devtank-ltd/kicad_hiltop_seni_board/Sensi_Board_BOM_wcost.ods

Sheet: PCB
Customer | Product Group |  | Item No. | Description | Details | Mf. Part No. | Supplier 1 | Part no. 1 | Cost 1 | Supplier 2 | Part no. 2 | Cost 2
JMA | 300 |  | 001 | Production RET Tester – Main Board | 1.6mm FR4 4 Layer
 |  |  | 002 | Production RET Tester – Connector Board | 1.6mm FR4 4 Layer
 | 301 |  | 001 | Autosense – Connector Board | 1.6mm FR4 4 Layer
 | 301 |  | 002 | Autosense – Power Load Board | 1.6mm FR4 4 Layer
 | 301 |  | 003 | Autosense – Test fixture PCB | 1.6mm FR4 4 Layer
Sheffield Uni | 302 |  | 001 | Roving Sensor Board | 1.6mm FR4 4 Layer
RedEmbedded | 303 | - | 001 | OVO Motherboard | 1.6mm FR4 4 Layer
HILTOP | 304 | - | 001 | Motherboard | 1.6mm FR4 4 Layer
 | 304 |  | 002 | Backplane | 1.6mm FR4 4 Layer
 | 304 |  | 003 | FPGA Modolu Board | 1.6mm FR4 4 Layer
 | 304 |  | 004 | USB Front Panel Board | 1.6mm FR4 4 Layer
 |  |  | 005 | Rear Connector Panel | 1.6mm FR4 4 Layer
 |  |  | 006 | LoTa IO Board (Plug-in) | 1.6mm FR4 4 Layer
Indra | 305 | - | 001 | Smart Charger Breakout Board | 1.6mm FR4 4 Layer
Teledyne | 306 | - | 001 | LED Interface Board A – JIG | 1.6mm FR4 4 Layer
 | 306 |  | 002 | LED Interface Board B – HILTOP | 1.6mm FR4 4 Layer
 | 307 | -
 | 308 | -
 | 309 | -
 | 310 | - | 001
 | 311 | -
 | 312 | -
 | 313 | -
 | 314 | -
 | 315 | -
 | 316 | -
 | 317 | -
 | 318 | -
 | 319 | -
 | 320 | -
 | 321 | -
 | 322 | -
 | 323 | -
 | 324 | -
 | 325 | -
 | 326 | -
 | 327 | -
 | 328 | -
 | 329 | -
 | 330 | -
 | 331 | -
 | 332 | -
 | 333
 | 334

Sheet: Sensi_Board
Title | Sensi Board
Revision | Draft
Date | 2019-10-01
Generated | Wed 23 Oct 2019 13:36:07 BST
Company
Comment 1
Comment 2
Comment 3
Comment 4
Total Parts | 434
Total Unique Parts | 78
Ref | Qty | Value | Footprint | Devtank | Dielectric | Tolerance | Voltage | Description | Manufacturer | Manufacturer Part Number | Supplier | Supplier Part number | Cost (unit) | Cost (total)
C1 C3 C7 C8 C20 C21 C22 C25 C32 C35 C39 C43 C48 C51 C62 C70 C81 C82 | 18 | 100nF | Capacitor_SMD:C_0603_1608Metric | 105-002 |  |  |  | 100nF 50V X7R | Kemet | C0603C104M5RACTU | Farnell | 2581046 | 0.018 | 0.324
C2 C4 C5 C6 C9 C12 C14 C15 C16 C17 C18 C19 C23 C24 C26 C27 C28 C29 C30 C56 C60 C61 C66 C67 C73 C74 C79 C80 | 28 | 100nF | Capacitor_SMD:C_0402_1005Metric | 105-019 |  |  |  | 100nF 50V X7R | Murata Electronics | GRM155R71H104ME14D | Digikey | 490-10701-1-ND | 0.0151 | 0.4228
C10 C11 | 2 | 10uF | Capacitor_SMD:C_0805_2012Metric | 105-001 |  |  |  | 10uF 16V X5R 10% MLCC | AVX | 0805YD106KAT2A | Farnell | 1658880 | 0.425 | 0.85
C13 | 1 | 100uF | Capacitor_SMD:CP_Elec_6.3x7.7 | 108-003 |  |  |  | 100uF 50V 0.34R FT Series | Panasonic | EEEFTH101XAP | Farnell | 1868426 | 0.592 | 0.592
C31 C33 C34 C36 C38 C41 C42 C44 | 8 | 1uF | Capacitor_SMD:C_0603_1608Metric | 105-027 |  |  |  | 1uF 50V X5R | Samsun Electro-Mechanics | CL10A105KB8NNNC | Farnell | 3013383 | 0.106 | 0.848
C37 C40 C45 C46 C53 C68 C72 C83 C92 C94 C95 C96 C97 C98 C99 C101 | 16 | 0.1uF | Capacitor_SMD:C_0402_1005Metric | 105-019 |  |  |  | 100nF 50V X7R | Murata Electronics | GRM155R71H104ME14D | Digikey | 490-10701-1-ND | 0.0151 | 0.2416
C47 C49 C50 C54 C59 C65 C69 C71 | 8 | 1nF | Capacitor_SMD:C_0603_1608Metric | 105-026 |  |  |  | 1000pF 50V X7R | Multicomp PRO | MCU0603R102KCT | Farnell | 9406174 | 0.023 | 0.184
C52 | 1 | DNF | Capacitor_SMD:C_0603_1608Metric
C55 C102 C104 | 3 | 4.7uF | Capacitor_SMD:C_0402_1005Metric | 105-028 | X5R |  | 6.3V | 4.7uF 6.3V X5R | muRata | GRM155R60J475ME47D | Farnell | 2426952RL | 0.106 | 0.318
C57 C58 C63 C64 | 4 | DNF | Capacitor_SMD:C_0805_2012Metric
C75 C76 | 2 | 18pF | Capacitor_SMD:C_0603_1608Metric | 106-003 |  |  |  | 18pF COG/NPO | AVX | 06035A180JAT2A | Farnell | 1612182 | 0.0681 | 0.1362
C77 C78 | 2 | 4.3pF | Capacitor_SMD:C_0603_1608Metric | 106-014 |  |  |  | 4.3pF COG/NPO | Kemet | C0603C439D1HACTU | Mouser | 80-C0603C439D1HACTU | 0.019 | 0.038
C88 C89 | 2 | 33pF | Capacitor_SMD:C_0603_1608Metric | 106-015 |  |  |  | 33pF COG/NPO | Multicomp Pro | MC0603N330J500CT | Farnell | 1759059 | 0.0311 | 0.0622
C90 | 1 | 0.1uF | Capacitor_SMD:C_0603_1608Metric | 105-002 |  |  |  | 100nF 50V X7R | Kemet | C0603C104M5RACTU | Farnell | 2581046 | 0.018 | 0.018
C91 | 1 | 1.0uF | Capacitor_SMD:C_0402_1005Metric | 105-025 | X5R |  | 16V | 1uf 16V X5R | Taiyo Yuden | EMK105BJ105KV-F | Farnell | 2113064 | 0.0415 | 0.0415
C100 C103 C105 | 3 | 4.7uF | Capacitor_SMD:C_0402_1005Metric | 105-028 | X5R |  | 6.3V | 4.7uF 6.3V X5R | muRata | GRM155R60J475ME47D | Farnell | 2426952RL | 0.106 | 0.318
C106 | 1 | DNF | Capacitor_SMD:C_0402_1005Metric
D1 | 1 | B240A-13 | Diode_SMD:D_SMA | 133-008 |  |  |  | B240A-13-F - Schottky Rectifier, 40 V, 2 A, Single, DO-214AC, 2 Pins, 500 mV | Diodes Inc. | B240A-13-F | Farnell | 1843669 | 0.329 | 0.329
D2 D3 D5 D13 | 4 | GRN | LED_SMD:LED_0603_1608Metric | 110-002 |  |  |  | Green LED | Rohm Semiconductor | SML-D12P8WT86C | Farnell | 2687486 | 0.214 | 0.856
D4 | 1 | BAT54T1G | Diode_SMD:D_SOD-123 | 133-007 |  |  |  | BAT54T1G Small Signal Schottky Diode, Single, 30V, 200mA | ON Semi | BAT54T1G | Farnell | 1651157 | 0.159 | 0.159
D14 D16 D18 D20 D22 D24 | 6 | BAV99 | Package_TO_SOT_SMD:SOT-23 | 134-001 |  |  |  | BAV99 - Small Signal Diode, Dual Series, 75 V, 300 mA, 1.25 V, 4 ns, 4.5 | Diodes Inc | BAV99 | Farnell | 1902422 | 0.104 | 0.624
D32 | 1 | MBR230LSFT1G | Diode_SMD:D_SOD-123 | 133-006 |  |  |  | Schottky Rectifier, 30 V, 2 A, Single, SOD-123FL | ON Semi | MBR230LSFT1G | Farnell | 2317422 | 0.226 | 0.226
F1 | 1 | Polyfuse | Resistor_SMD:R_1206_3216Metric | 190-003 |  |  |  | PPTC Resettable Fuse, SMD, POLYFUSE 1206L | Littlefuse | 1206L075THYR | Farnell | 1822204 | 0.269 | 0.269
J1 J2 J4 J5 J7 J8 J9 | 7 | Conn_02x06_Top_Bottom | Devtank_PCB_Lib:Molex2x06 | 711-004 |  |  |  | Molex Milli-Grid 87831, 12 Way, 2 Row, Straight PCB Header | Molex | 87831-1219 | Mouser | 538-87831-1219 | 0.811 | 5.677
J3 | 1 | Conn_03x32_DIN41612 | Devtank_PCB_Lib:Socket_DIN41612-CaseC1-full-Male-96Pin-3rows_correct | 717-002 |  |  |  | 406AF-96-MSR-AAE4 (Cards) | Valcon | 406AF-96-MSR-AAE4 | Toby | 406AF-96-MSR-AAE4 | 1.54 | 1.54
J6 | 1 | Conn_02x10_Counter_Clockwise | Devtank_PCB_Lib:Molex_Milligrid_2x10 | 711-005 |  |  |  | 0878312019 Molex Milligrid 20 way 2 row | Molex | 878312019 | Digikey | WM23626-ND | 0.91 | 0.91
J10 | 1 | Conn_02x05_Counter_Clockwise | Connector_PinHeader_2.54mm:PinHeader_2x05_P2.54mm_Vertical | 710-020 |  |  |  | 2x5 THD - Valcon 2.54mm Pitch Dual Row Pin Header | Valcon | THD-05-R | Toby | THD-05-R | 0.09 | 0.09
JP1 | 1 | Jumper_NC_Dual | Connector_PinHeader_2.54mm:PinHeader_1x03_P2.54mm_Vertical | 710-014 |  |  |  | 3 Way Header (shroudless) THS - Valcon 2.54mm Single Row Pin Header | Valcon | THS-03-R | Toby | THS-03-R | 0.04 | 0.04
JP2 JP3 JP4 JP5 | 4 | Jumper_NC_Small | Connector_PinHeader_1.27mm:PinHeader_1x02_P1.27mm_Vertical | 714-005 |  |  |  | M50-3530242 - Board-To-Board Connector, 1.27 mm, 2 Contacts, Header | Harwin Inc | M50-3530242 | Farnell | 3226045 | 0.052 | 0.208
K1 | 1 | HRS1KH-S | Devtank_PCB_Lib:Relay_SPDT_HRS1KH-S | 141-002 |  |  |  | Signal Relay 5VDC SPDT 24V 3A HRS1K Series | Multicomp | HRS1KH-S DC5V | Farnell | 9480293 | 1.37 | 1.37
L1 | 1 | 500mA/0.10DCR | Inductor_SMD:L_0805_2012Metric | 113-004 |  |  |  | BMB2A0030AN8 30ohm 500ma 0.1ohm 25% | TE Connectivity | BMB2A0030AN8 | Farnell | 2483667 | 0.0874 | 0.0874
L3 L4 L6 L7 L11 | 5 | 2A/0.05DCR | Inductor_SMD:L_0805_2012Metric | 113-002 |  |  |  | Ferrite 220 ohm, 2 A, WE-CBF Series, 0.05 ohm, ± 25% | Wurth Elektronik | 742792022 | Farnell | 1635733 | 0.177 | 0.885
Q2 Q7 Q8 Q10 Q11 | 5 | ZXMN6A07F | Package_TO_SOT_SMD:SOT-23 | 170-002 |  |  |  | ZXMN6A07F N Channel 1A, 60V, 0.4Ohm | Diodes Inc | ZXMN6A07FTA | Farnell | 9525769 | 0.416 | 2.08
R1 R2 R5 R6 R50 | 5 | 470R | Resistor_SMD:R_0603_1608Metric | 101-001 |  |  |  | 470R 1% 75V | Vishay | CRCW0603470RFKEA | Farnell | 1469815 | 0.0149 | 0.0745
R3 R4 R7 R12 R14 R18 R21 R24 R26 R37 R38 R52 R99 R102 R105 R111 R120 R132 R133 R147 R148 R159 R160 R161 R162 | 25 | 10K | Resistor_SMD:R_0603_1608Metric | 101-010 |  |  |  | 10K 1% 75V | Vishay | CRCW060310K0FKEA | Farnell | 1469748 | 0.0153 | 0.3825
R8 R9 | 2 | DNF | Resistor_SMD:R_1206_3216Metric
R10 R11 | 2 | 0R | Resistor_SMD:R_1206_3216Metric | 101-007 |  |  |  | 0R 1206 200V | Vishay | CRCW12060000Z0EA | Farnell | 1469963 | 0.0377 | 0.0754
R13 R49 R53 R55 R63 R64 R65 R67 | 8 | 10R | Resistor_SMD:R_0603_1608Metric | 101-058 |  |  |  | 10R 1% 50V | Multicomp Pro | MCWR06X10R0FTL | Farnell | 2447233 | 0.0035 | 0.028
R15 R16 | 2 | 4K7 | Resistor_SMD:R_0603_1608Metric | 101-009 |  |  |  | 4K7 1% 75V | Vishay | CRCW06034K70FKEA | Farnell | 1469807 | 0.0149 | 0.0298
R17 R31 R33 R36 R74 R77 R96 R108 R110 R112 R137 R138 R143 R144 | 14 | DNF | Resistor_SMD:R_0603_1608Metric
R19 R22 R25 R27 | 4 | 16K | Resistor_SMD:R_0603_1608Metric | 101-052 |  |  |  | 16K 1% 75V | Vishay | CRCW060316K0FKEA | Farnell | 2138433 | 0.0192 | 0.0768
R20 | 1 | 47K | Resistor_SMD:R_0603_1608Metric | 101-016 |  |  |  | 47K 1% 50V | Bourns Inc | CR0603-FX-4702ELF | Farnell | 2333548 | 0.0193 | 0.0193
R23 R28 R29 R35 | 4 | 100R | Resistor_SMD:R_0603_1608Metric | 101-018 |  |  |  | 100R 1% 50V 100mW CR Series | Bourns Inc | CR0603-FX-1000ELF | Farnell | 2008332 | 0.0196 | 0.0784
R30 R32 R34 R60 R61 R66 R76 R79 R80 R83 R84 R114 R116 R121 R149 | 15 | 0R | Resistor_SMD:R_0603_1608Metric | 101-005 |  |  |  | 0R 0603 75V | Vishay | CRCW06030000Z0EA | Farnell | 1469739 | 0.0153 | 0.2295
R39 R40 R90 R93 R94 R95 R106 R107 R139 R140 | 10 | 100K | Resistor_SMD:R_0603_1608Metric | 101-015 |  |  |  | 100K 1% 50V | Multicomp Pro | MCWR06X1003FTL | Farnell | 2447226 | 0.0034 | 0.034
R41 R45 R85 R86 R97 R98 | 6 | DNF | Resistor_SMD:R_0805_2012Metric
R42 R43 R88 R89 R100 R101 R119 R122 R125 R126 R127 R128 R129 R130 R151 R152 R153 R154 | 18 | 1K | Resistor_SMD:R_0603_1608Metric | 101-012 |  |  |  | 1K 1% 75V | Vishay | CRCW06031K00FKEA | Farnell | 1469740 | 0.0151 | 0.2718
R44 R46 R91 R92 R103 R104 | 6 | 0R | Resistor_SMD:R_0805_2012Metric | 101-006 |  |  |  | 0R 0805 | Vishay | CRCW08050000Z0EA | Farnell | 1469846 | 0.0224 | 0.1344
R47 R51 | 2 | 4.7K | Resistor_SMD:R_0603_1608Metric | 101-009 |  |  |  | 4K7 1% 50V | Vishay | CRCW06034K70FKEA | Farnell | 1469807 | 0.0149 | 0.0298
R48 | 1 | 2K2 | Resistor_SMD:R_0603_1608Metric | 101-011 |  |  |  | 2.2K 1% | Vishay | CRCW06032K20FKEA | Farnell | 1469765 | 0.0153 | 0.0153
R54 R57 R69 R70 | 4 | 30R | Resistor_SMD:R_0603_1608Metric | 103-004 |  | 0.1% |  | 30R 0.1% | TE Connectivity | CPF0603B30RE1 | Farnell | 2331137 | 0.139 | 0.556
R56 R58 R71 R72 | 4 | 12.4K | Resistor_SMD:R_0603_1608Metric | 103-003 |  | 0.1% |  | 12.4K 0.1% | Multicomp Pro | MCWF06R1242BTL | Farnell | 2336957 | 0.0935 | 0.374
R59 R62 R73 R113 R115 R123 R155 R156 | 8 | DNF | Resistor_SMD:R_0603_1608Metric |  |  | 0.1%
R68 R131 R157 R158 | 4 | 1.58K | Resistor_SMD:R_0603_1608Metric | 103-005 |  | 0.1% |  | 1.58K 0.1% | Panasonic | ERA3AEB1581V | Farnell | 1809753 | 0.241 | 0.964
R75 | 1 | 10K | Resistor_SMD:R_0603_1608Metric | 101-010 |  |  |  | 10K 1% | Vishay | CRCW060310K0FKEA | Farnell | 1469748 | 0.0153 | 0.0153
R78 | 1 | 24K | Resistor_SMD:R_0603_1608Metric | 101-055 |  |  |  | 24k 1% | Multicomp Pro | MCWR06X2402FTL | Farnell | 2447308 | 0.0034 | 0.0034
R81 R82 R124 R141 R142 | 5 | 330R | Resistor_SMD:R_0603_1608Metric | 101-024 |  |  |  | 330R 1% | Vishay | CRCW0603330RFKEA | Farnell | 1469803 | 0.0149 | 0.0745
R87 | 1 | 1M | Resistor_SMD:R_0603_1608Metric | 101-056 |  |  |  | 1M 1% | Multicomp Pro | MCWR06X1004FTL | Farnell | 2447285 | 0.0035 | 0.0035
R109 | 1 | 12.0K | Resistor_SMD:R_0603_1608Metric | 101-044 |  | 1% |  | 12K 1% 50V 100mW | Bourns Inc | CR0603-FX-1202ELF | Farnell | 2333583 | 0.0193 | 0.0193
R117 R118 R134 R135 R136 R145 R146 R150 | 8 | 10M | Resistor_SMD:R_0603_1608Metric | 101-057 |  |  |  | 10M 1% | Multicomp Pro | MCWR06W1005FTL | Farnell | 2447232 | 0.0041 | 0.0328
SW1 | 1 | SW_Push | Button_Switch_SMD:SW_SPST_B3U-1000P | 780-001 |  |  |  | Switch SMT Micro SPST-NO | Omron | B3U-1000P | Mouser | 653-B3U-1000P | 0.794 | 0.794
SW2 SW3 SW4 SW5 | 4 | SW_DIP_x04 | Button_Switch_SMD:SW_DIP_SPSTx04_Slide_Copal_CHS-04B_W7.62mm_P1.27mm | 193-003 |  |  |  | 4 Way Surface Mount DIP Switch SPST, Flush Slide Actuator | Apem | DHA-04T-Q | RS Online | 877-2390 | 1.16 | 4.64
TP1 TP2 TP3 TP4 TP5 TP6 TP7 TP8 TP9 TP10 TP11 TP12 TP13 TP14 TP15 TP16 TP17 TP18 TP19 TP25 TP26 TP27 TP28 TP29 TP30 TP31 TP32 TP33 TP34 TP35 TP36 TP37 TP38 TP39 TP40 TP45 TP46 TP49 TP51 TP52 TP53 TP54 TP55 TP56 TP57 TP58 TP59 TP60 TP61 TP62 TP63 TP64 TP65 TP66 TP67 TP68 TP69 TP70 TP71 TP72 TP73 TP74 TP75 TP76 TP77 TP78 TP79 TP80 TP81 TP82 TP83 TP84 TP85 TP86 TP87 TP88 TP89 TP90 TP91 TP92 TP93 TP94 TP95 TP96 TP97 TP98 TP99 TP100 TP101 TP102 TP103 TP104 TP105 TP106 TP107 TP126 | 96 | Test_Point | TestPoint:TestPoint_THTPad_D1.0mm_Drill0.5mm
U1 | 1 | INA250A4 | Package_SO:TSSOP-16_4.4x5mm_P0.65mm | 119-002 |  |  |  | INA250 Current Shunt Monitor 2V/A (A4) | Texas Instruments | INA250A4PWR | Digikey | 296-43804-1-ND | 2.183 | 2.183
U2 | 1 | LD1117S33TR_SOT223 | Package_TO_SOT_SMD:SOT-223-3_TabPin2 | 150-004 |  |  |  | LM1117IMP-3.3 Fixed LDO Regulator 3.3V | Texas Instruments | LM1117IMP-3.3/NOPB | Digikey | LM1117IMP-3.3/NOPBCT-ND | 0.797 | 0.797
U3 | 1 | AT25DN512CSSHF-B | Package_SO:SOIC-8_3.9x4.9mm_P1.27mm | 129-002 |  |  |  | 512K, 2.3V, 104MHz Serial Flash | Adesto | AT25DN512C-SSHF-B (https://www.mouser.co.uk/ProductDetail/Adesto-Technologies/AT25DN512C-SSHF-B) | Mouser | 988-AT25DN512CSSHF-B | 0.233 | 0.233
U4 U5 | 2 | AD8646 | Package_SO:SOIC-8_3.9x4.9mm_P1.27mm | 120-006 |  |  |  | AD8646ARZ Analog Devices, Op Amp, RRIO, 24MHz, 3 V, 5 V, 8-Pin SOIC | Analog Devices | AD8646ARZ | RS Online | 709-7278 | 1.882 | 3.764
U6 | 1 | LM75B | Package_SO:SOIC-8_3.9x4.9mm_P1.27mm | 155-005 |  |  |  | LM75BD Temperature Sensor -55degC to +125degC | NXP | LM75BD | Farnell | 1854077 | 0.494 | 0.494
U7 | 1 | DNF | Package_SO:SOIC-8_3.9x4.9mm_P1.27mm
U8 U9 U10 U11 | 4 | MAX31865 | Package_DFN_QFN:TQFN-20-1EP_5x5mm_P0.65mm_EP3.1x3.1mm | 155-006 |  |  |  | MAX31865ATP+ RTD chip | Maxim Integrated | MAX31865ATP+ | RS Online | 866-6087 | 2.56 | 10.24
U12 U16 U19 U20 U21 U23 U24 U25 | 8 | MAX4194 | Package_SO:SOIC-8_3.9x4.9mm_P1.27mm | 120-005 |  |  |  | MAX4194ESA+ Maxim, Instrumentation Amplifier, 0.69mV Offset 250kHz, R-RO, 2.7 → 7.5 V, 8-Pin SOIC | Maxim | MAX4194ESA+ | Mouser | 700-MAX4194ESA | 2.5 | 20
U13 | 1 | CP2102N-A01-GQFN24 | Package_DFN_QFN:QFN-24-1EP_4x4mm_P0.5mm_EP2.6x2.6mm_ThermalVias | 118-007 |  |  |  | CP2102N USB to UART adapter IC | Silicon Labs | CP2102N-A01-GQFN24 | Digikey | 336-3693-ND | 1.09 | 1.09
U14 U15 U17 U18 | 4 | BTS4140N | Package_TO_SOT_SMD:SOT-223 | 146-001 |  |  |  | BTS4140NHUMA1 Smart Power Switch, SIPMOS Technology, High Side, 1 Output, 0.7A, | Infineon | BTS4140NHUMA1 | Farnell | 2215503 | 1.07 | 4.28
U22 | 1 | STM32F072RBTx | Package_QFP:LQFP-64_10x10mm_P0.5mm | 126-001 |  |  |  | STM32F072RBT6, 32bit ARM Cortex M0 Microcontroller, 48MHz, 64 kB, 128 kB Flash | ST Microelectronics | STM32F072RBT6 | RS Online | 907-4757 | 3.155 | 3.155
U27 | 1 | USB2502 | Package_DFN_QFN:QFN-36-1EP_6x6mm_P0.5mm_EP3.7x3.7mm | 118-012 |  |  |  | USB2502 | Microchip | USB2502-AEZG | Mouser | 886-USB2502-AEZG | £1.96 | £1.96
Y1 | 1 | 50ppm 24.000MHZ | Crystal:Crystal_SMD_TXC_7A-2Pin_5x3.2mm | 181-011 |  |  |  | TXC 24MHz crystal 30ppm | TXC | 7A-24.000MAHE-T | Mouser | 717-7A-24.000MAHE-T | 0.496 | 0.496
Y2 | 1 | 8MHZ | Crystal:Crystal_SMD_Abracon_ABM3C-4Pin_5.0x3.2mm | 181-009 |  |  |  | ABM3B-8.000MHZ-B2-T - Crystal, 8 MHz, SMD, 5mm x 3.2mm, 50 ppm, 18 pF, 20 ppm | Abracon | ABM3B-8.000MHZ-B2-T | Farnell | 2467818 | 0.501 | 0.501
Y3 | 1 | ABS25-32.768KHZ-6-T | Crystal:Crystal_SMD_7050-4Pin_7.0x5.0mm | 181-008 |  |  |  | Crystal, 32.768 kHz, SMD, 8mm x 3.8mm | Abracon | ABS25-32.768KHZ-6-T | Farnell | 2101354 | 0.518 | 0.518
 |  |  |  |  |  |  |  |  |  |  |  |  |  | 78.412
BOM made with KICAD_BOM_WIZARD (https://github.com/HashDefineElectronics/KiCad_BOM_Wizard.git)
Generated Wed 23 Oct 2019 13:36:07 BST
