devtank-ltd/kicad_hiltop_seni_board/kicad_hiltop_sensi_board/Sensi_Board.pdf

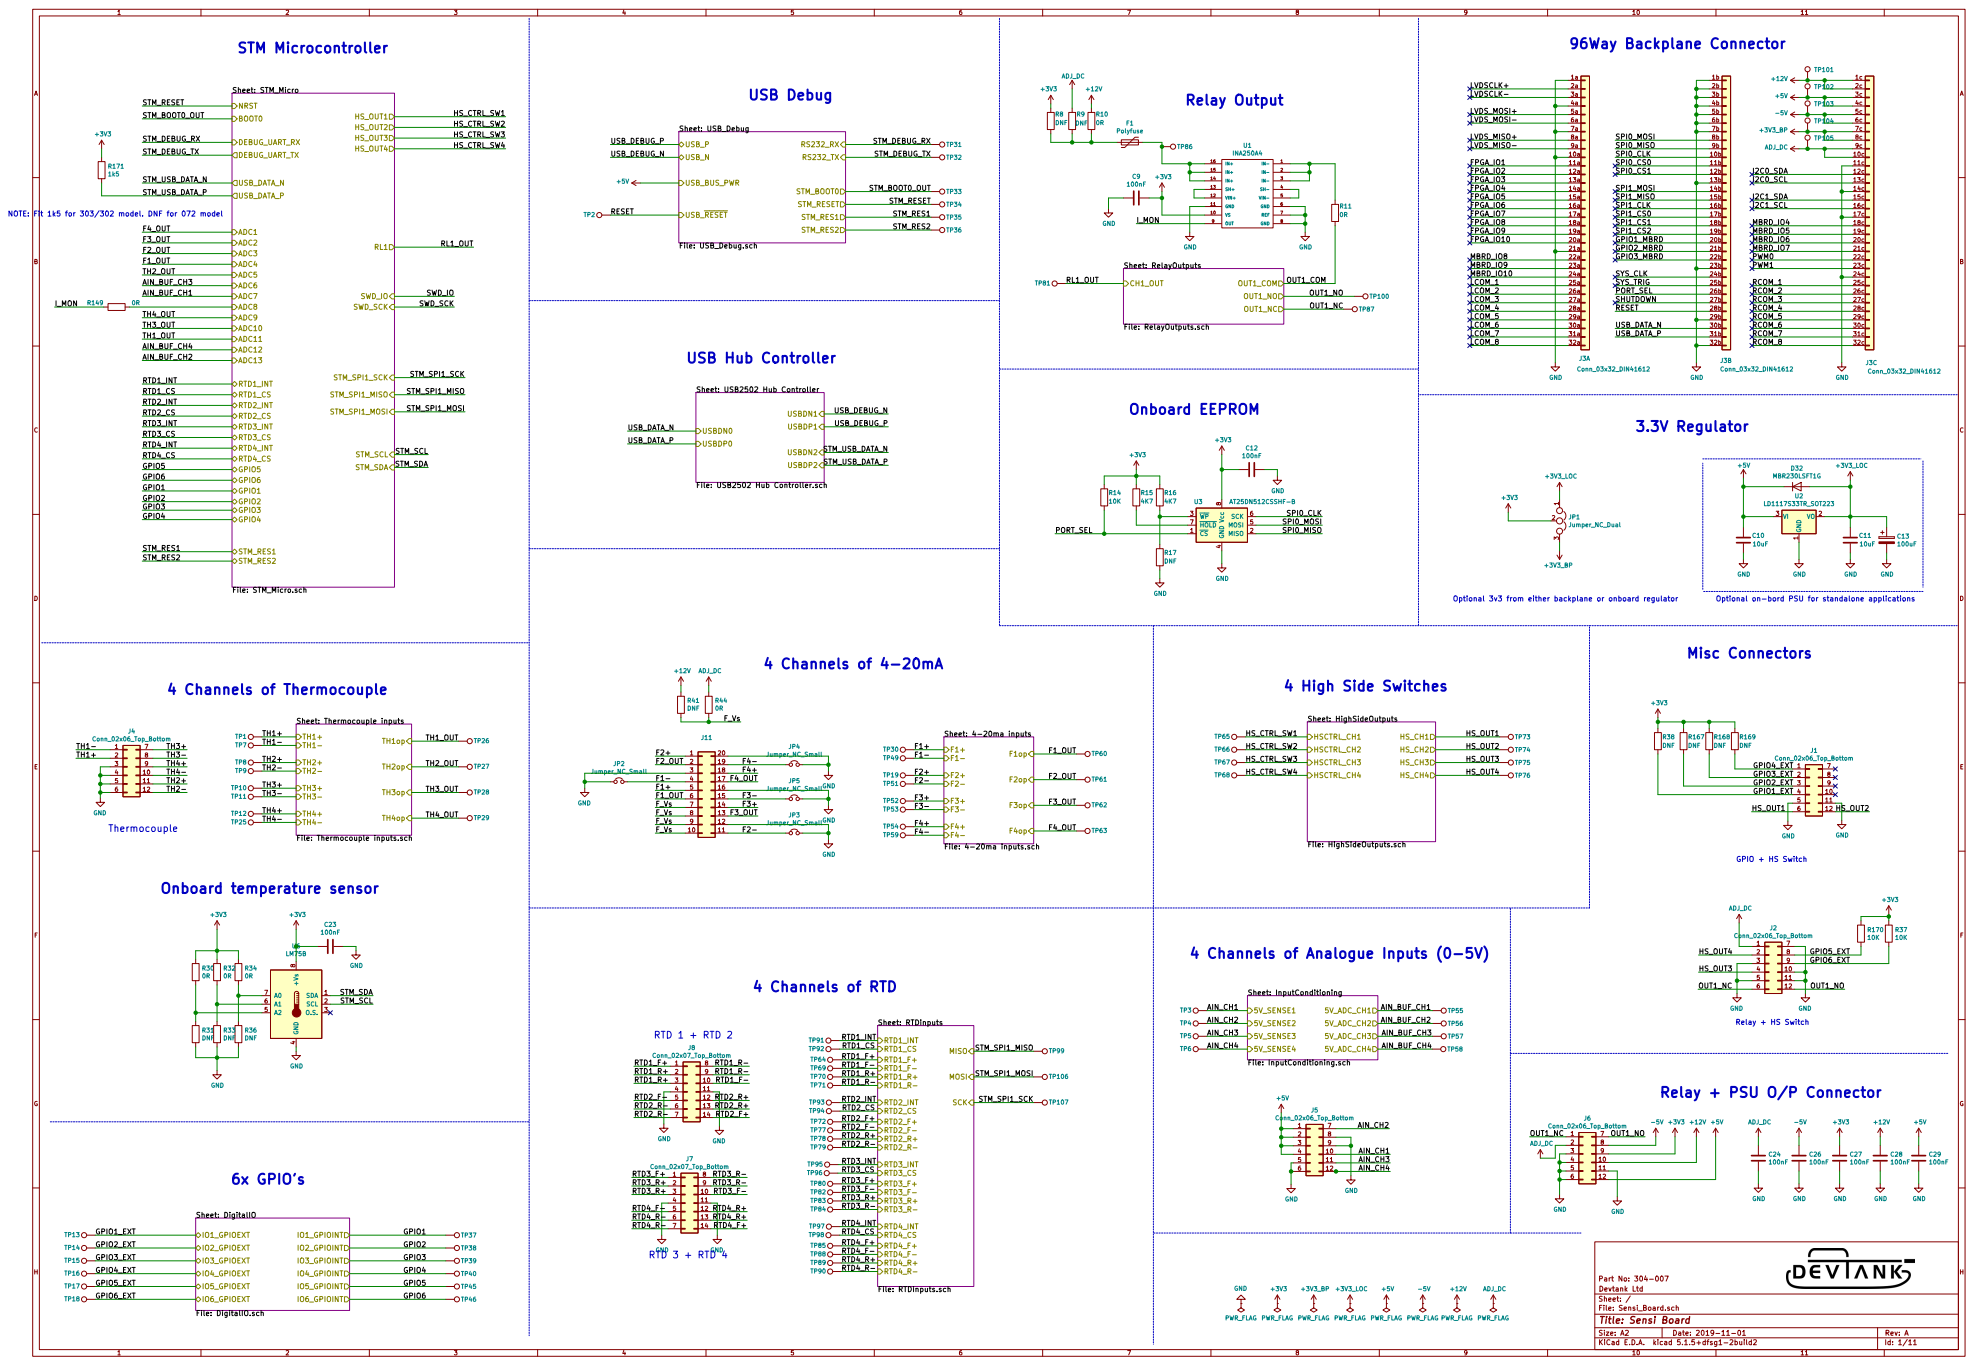
[picture p1: page 1]

NOTE: Fit 1k5 for 303/302 model. DNF for 072 model

File: USB2502 Hub Controller.sch

Optional 3v3 from either backplane or onboard regulator

Optional on-bord PSU for standalone applications

4 Channels of Analogue Inputs (0-5V)

File: Sensi_Board.sch Sheet: / Devtank Ltd Part No: 304-007

Id: 1/11 Title: Sensi Board

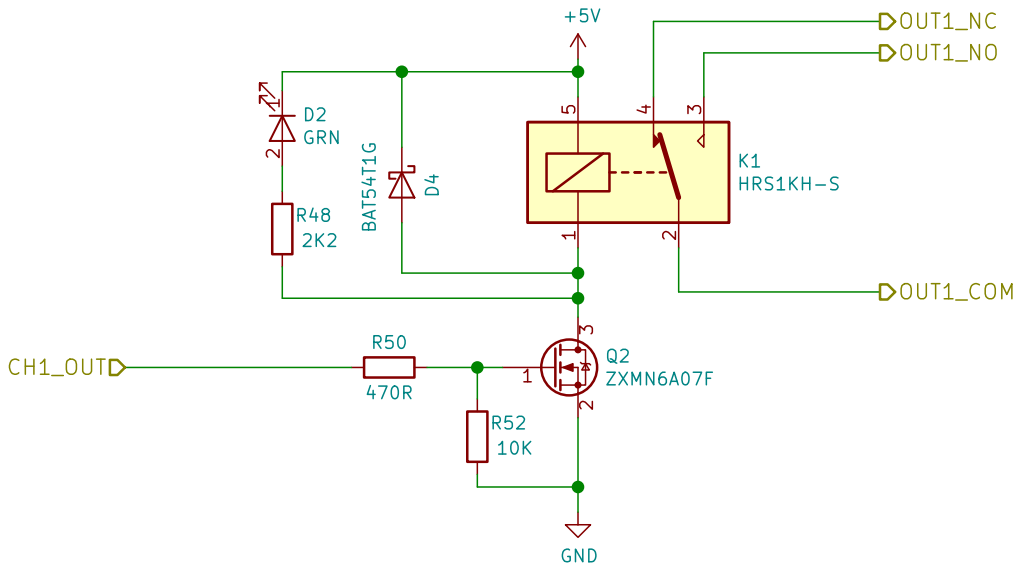
[picture p2: page 2]

Sheet: /RelayOutputs/ Devtank Ltd Part No: 304-007 D4 BAT54T1G

File: RelayOutputs.sch
Id: 2/11 Title: Sensi Board

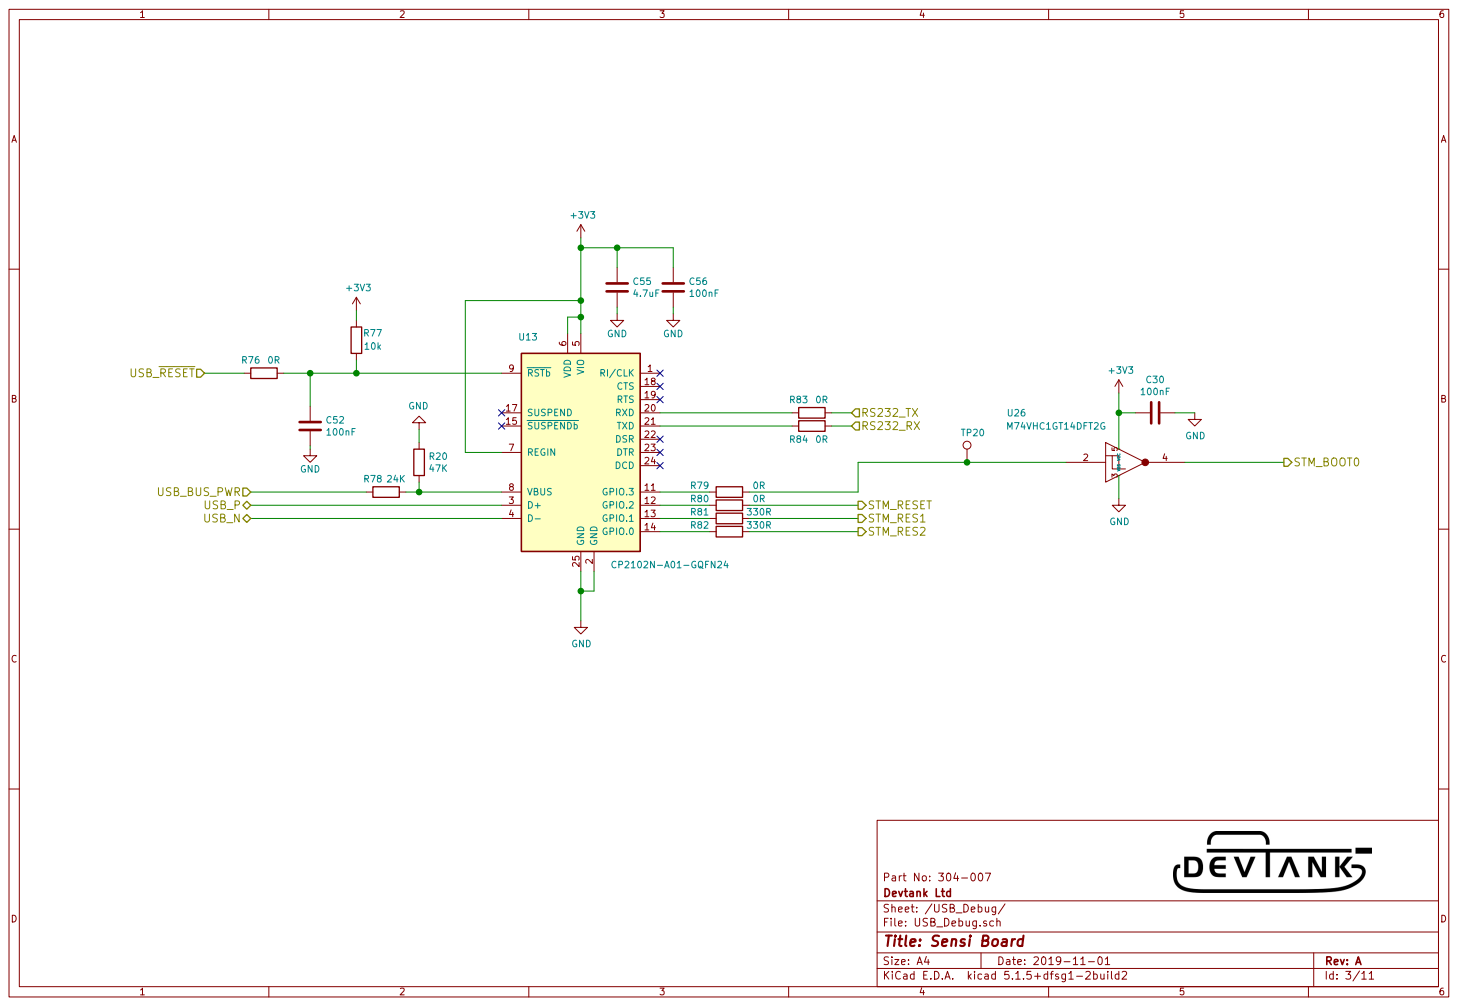
[picture p3: page 3]

6 REGIN 7 VBUS 8 RSTb 9 U13 CP2102N-A01-GQFN24 GND RS232_TX

2 RXD 20 TXD 21 DSR 22 DTR 23 DCD 24 GND 25 D+ 3 D- 4 VIO

Sheet: /USB_Debug/ Devtank Ltd Part No: 304-007

File: USB_Debug.sch
Id: 3/11 Title: Sensi Board

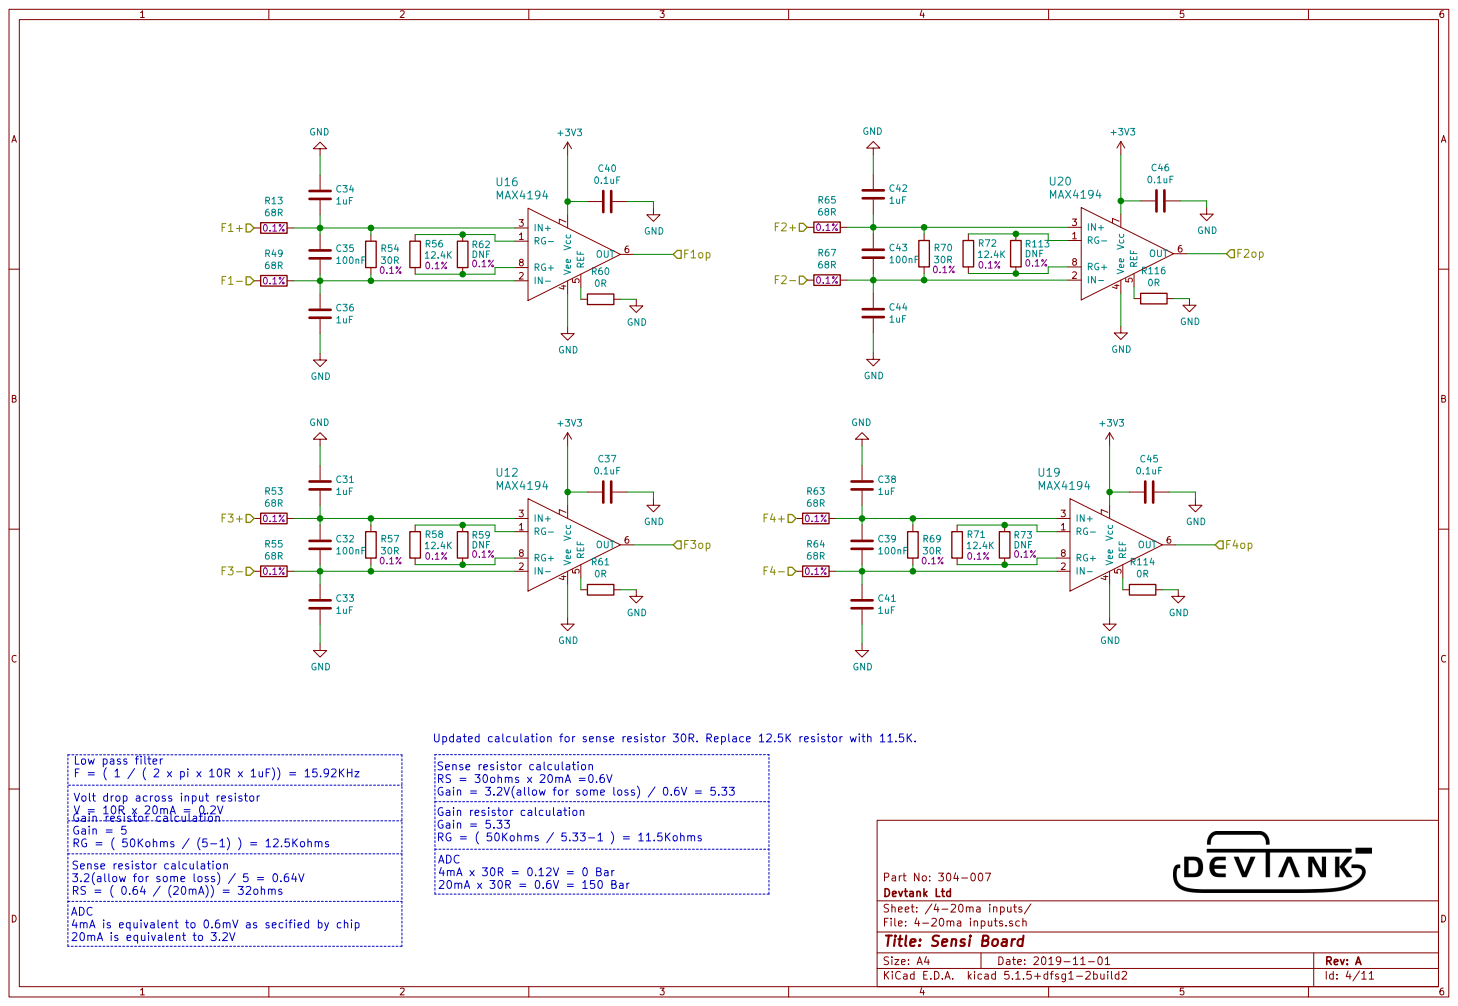
[picture p4: page 4]

5 OUT 6 Vcc 7 RG+ 8 U12 MAX4194 GND

5 OUT 6 Vcc 7 RG+ 8 U19 MAX4194 GND

Updated calculation for sense resistor 30R. Replace 12.5K resistor with 11.5K.

Low pass filter
F = ( 1 / ( 2 x pi x 10R x 1uF)) = 15.92KHz
Volt drop across input resistor V = 10R x 20mA = 0.2V Gain resistor calculation

4mA x 30R = 0.12V = 0 Bar 20mA x 30R = 0.6V = 150 Bar Sense resistor calculation
RS = 30ohms x 20mA =0.6V
Gain = 3.2V(allow for some loss) / 0.6V = 5.33
Gain resistor calculation
Gain = 5.33
RG = ( 50Kohms / 5.33-1 ) = 11.5Kohms
ADC

Gain = 5
RG = ( 50Kohms / (5-1) ) = 12.5Kohms
Sense resistor calculation
3.2(allow for some loss) / 5 = 0.64V
RS = ( 0.64 / (20mA)) = 32ohms
4mA is equivalent to 0.6mV as secified by chip
20mA is equivalent to 3.2V

Sheet: /4-20ma inputs/ Devtank Ltd Part No: 304-007

File: 4-20ma inputs.sch
Id: 4/11 Title: Sensi Board

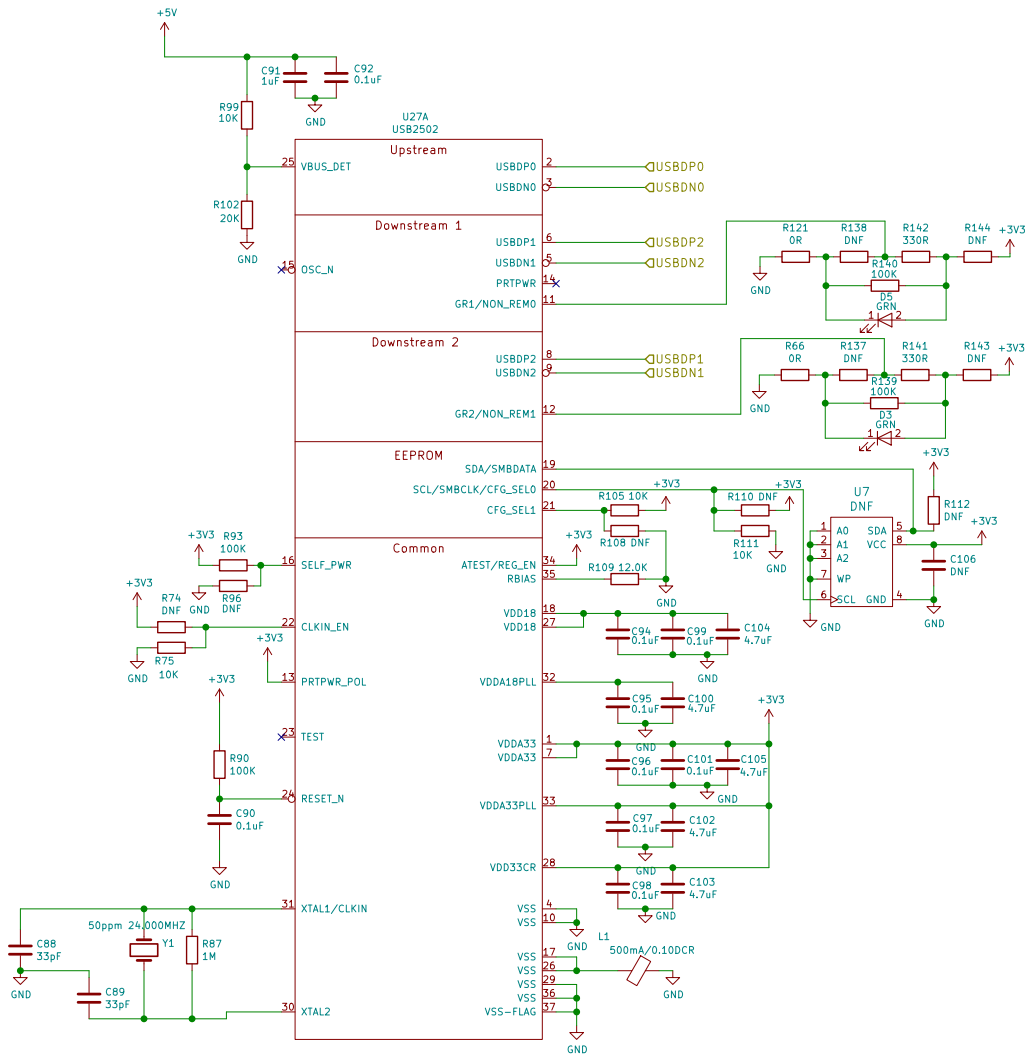
[picture p5: page 5]

Common Downstream 1 Downstream 2 Upstream

File: USB2502 Hub Controller.sch Sheet: /USB2502 Hub Controller/ Devtank Ltd Part No: 304-007

Id: 5/11 Title: Sensi Board

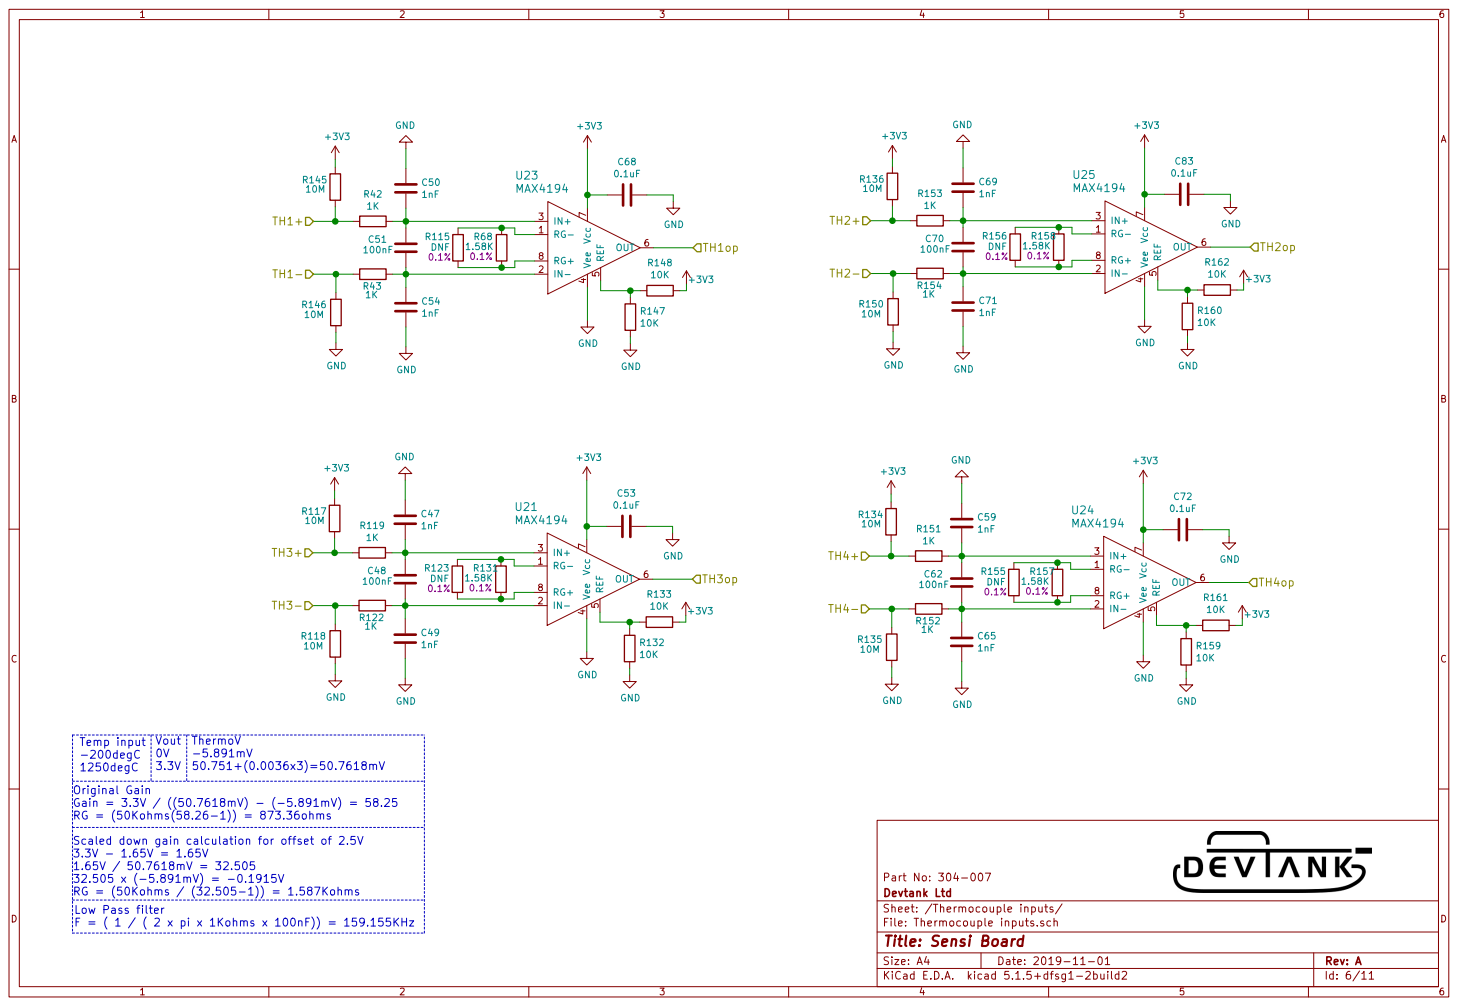
[picture p6: page 6]

Sheet: /Thermocouple inputs/ Devtank Ltd Part No: 304-007

Low Pass filter F = ( 1 / ( 2 x pi x 1Kohms x 100nF)) = 159.155KHz

File: Thermocouple inputs.sch
Id: 6/11 Title: Sensi Board

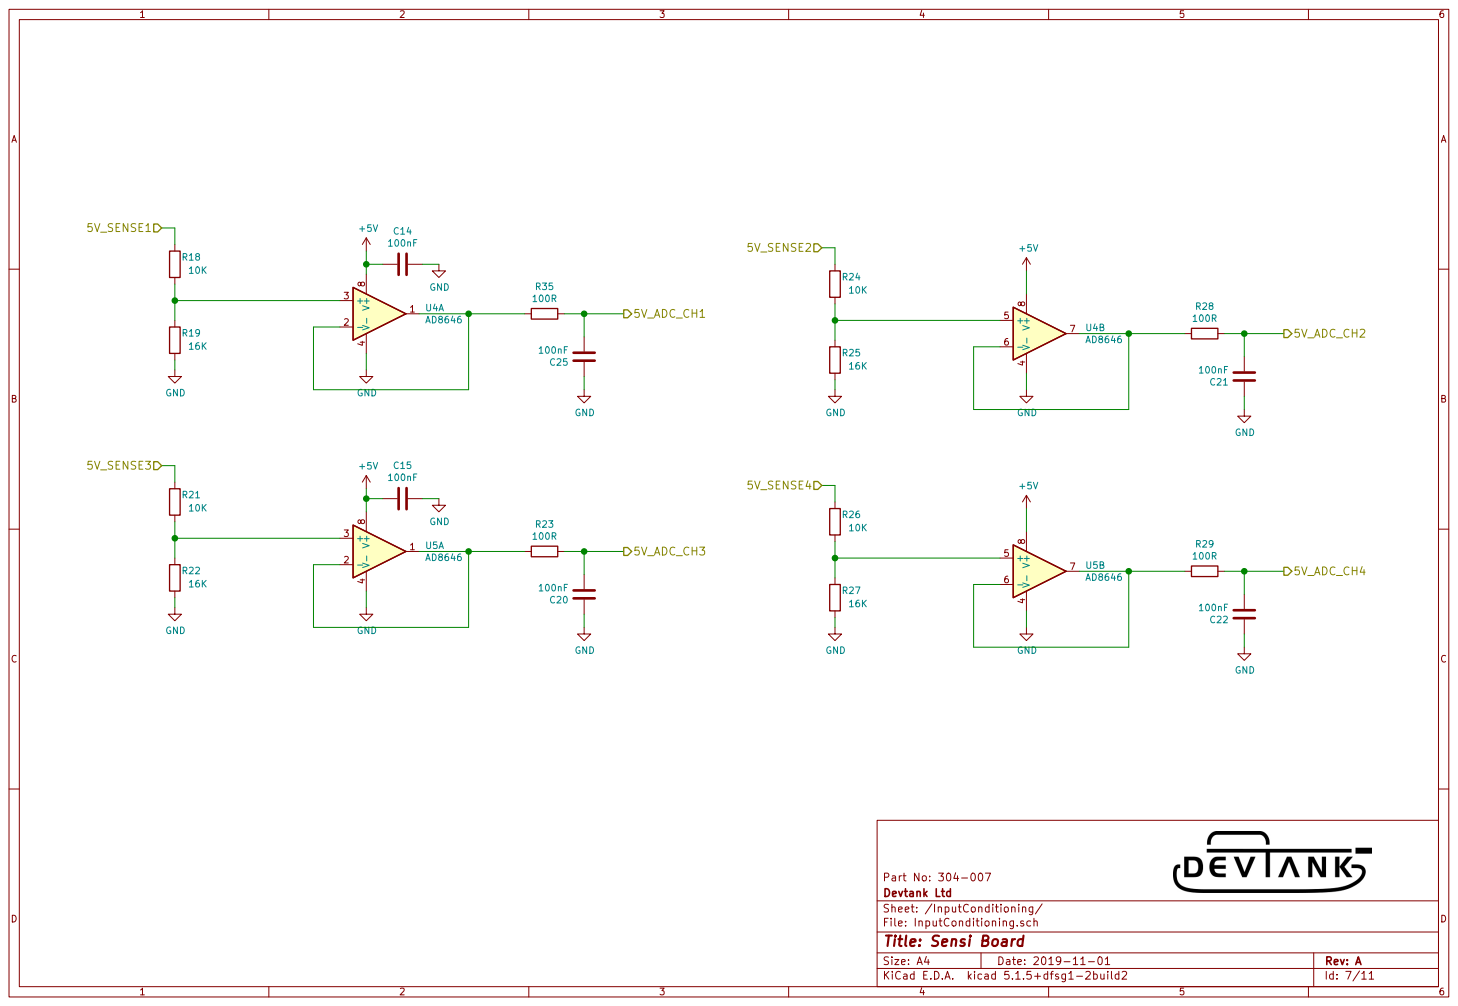
[picture p7: page 7]

File: InputConditioning.sch
Id: 7/11 Title: Sensi Board

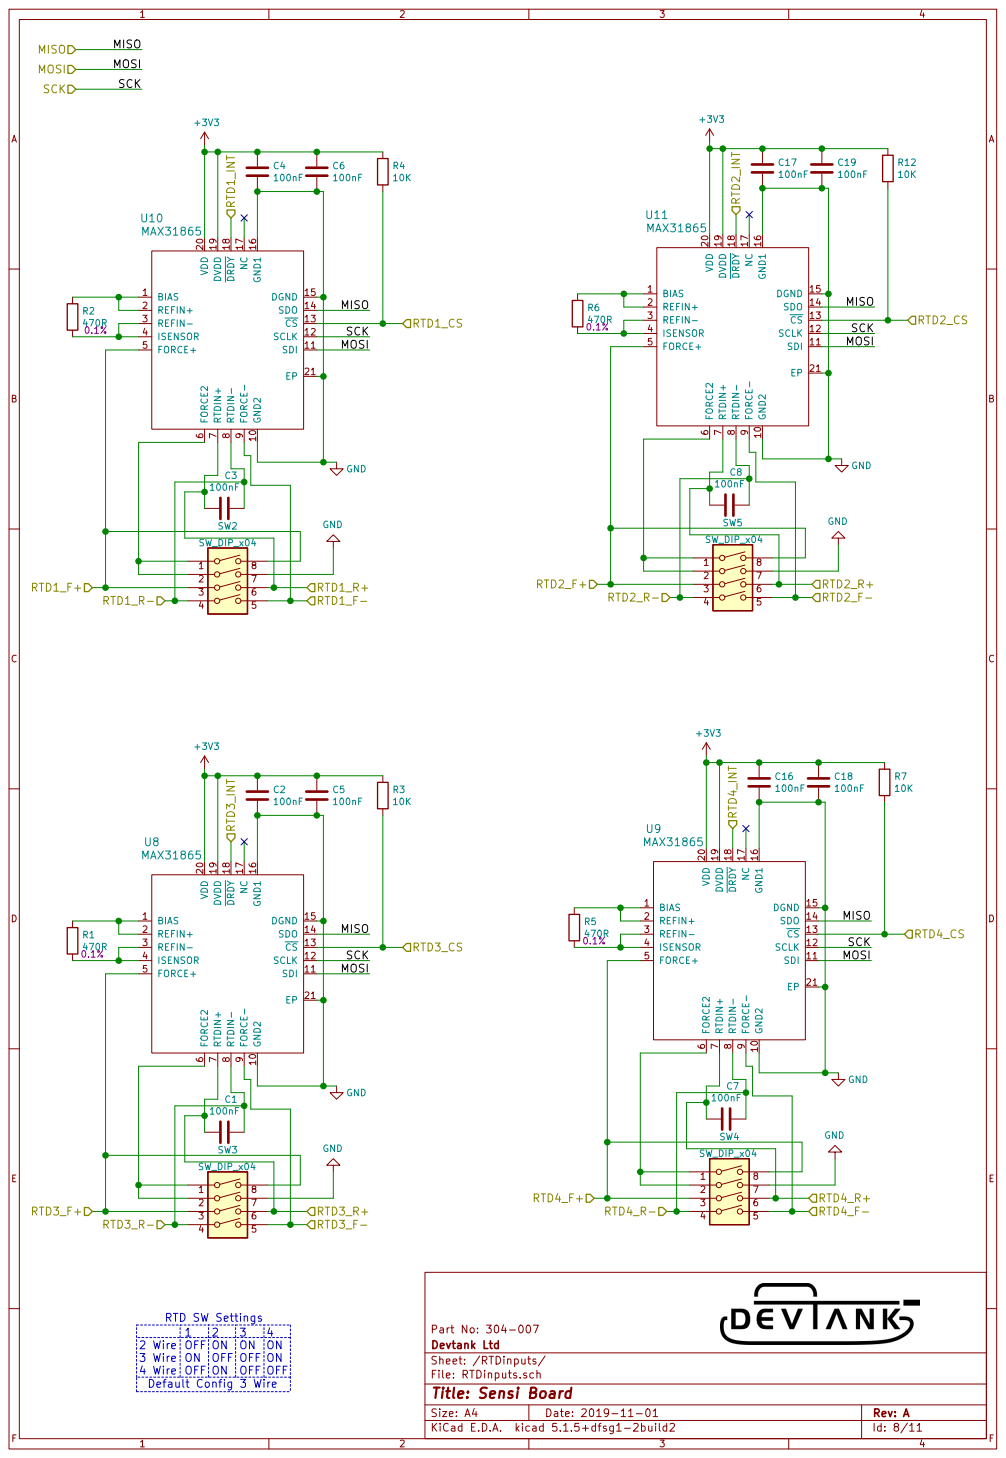
[picture p8: page 8]

1OFF | 3ON

Sheet: /RTDinputs/ Devtank Ltd Part No: 304-007

2 Wire 3 Wire 4 Wire | ON | ON | ON

File: RTDinputs.sch
Id: 8/11 Title: Sensi Board

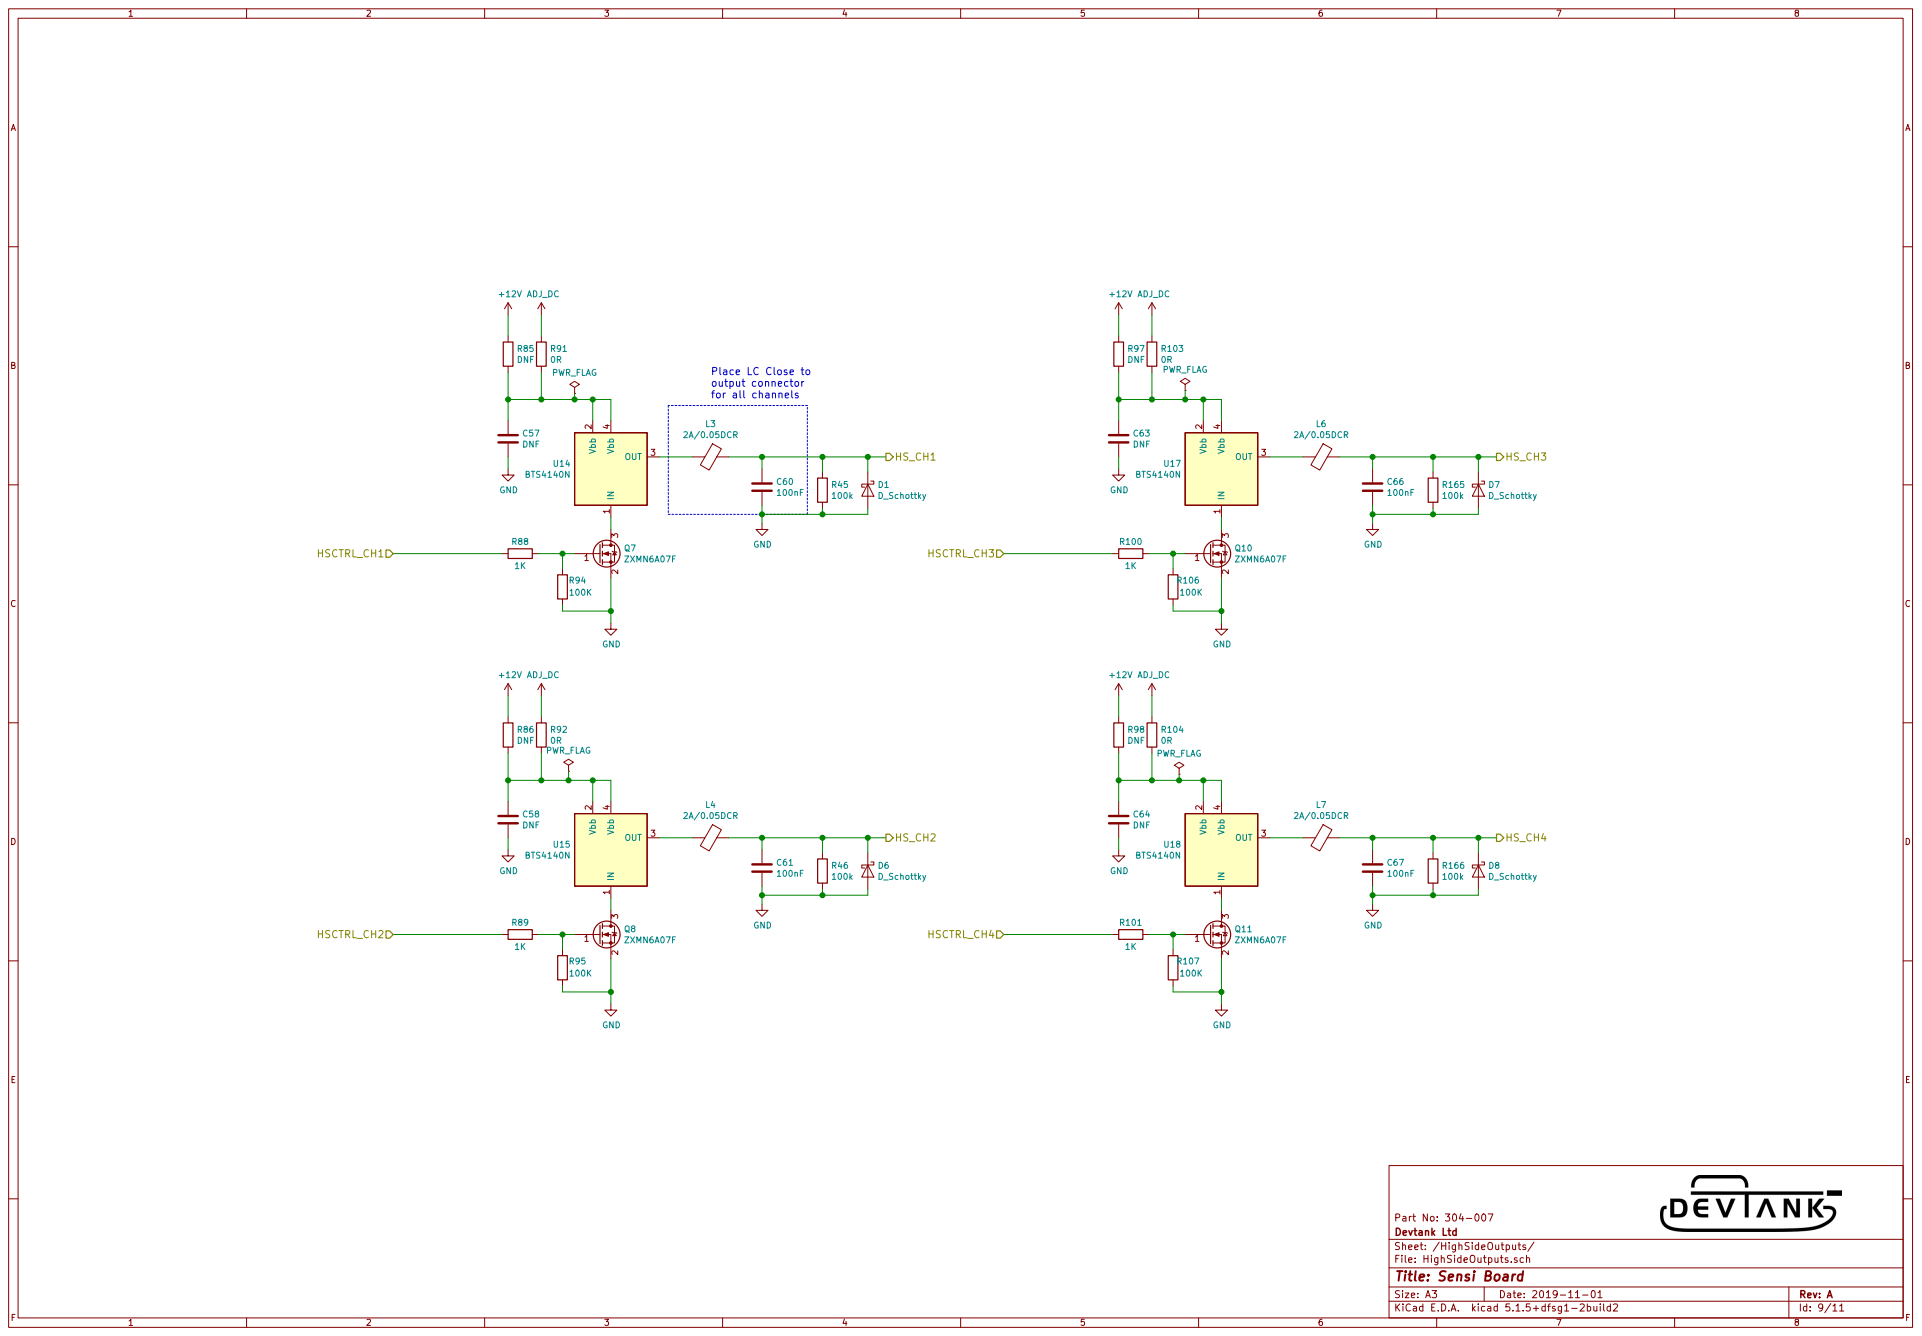
[picture p9: page 9]

Place LC Close to
output connector
for all channels

Sheet: /HighSideOutputs/ Devtank Ltd Part No: 304-007

File: HighSideOutputs.sch
Id: 9/11 Title: Sensi Board

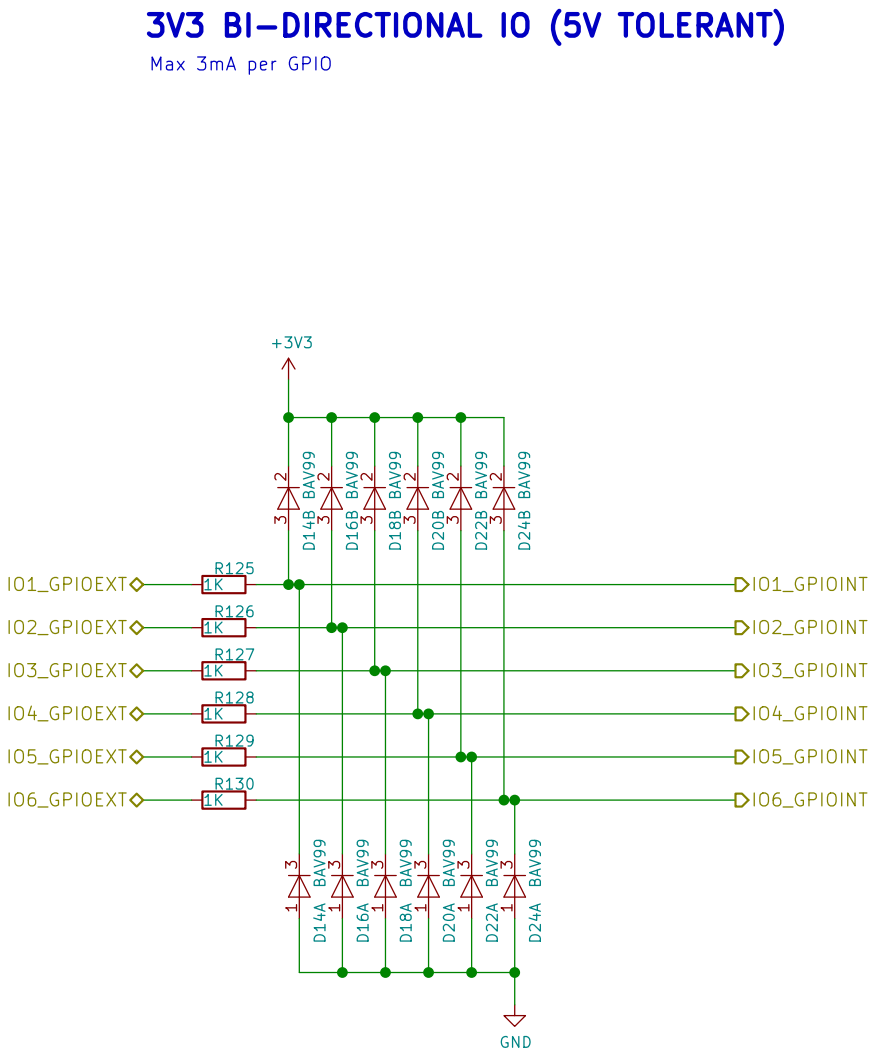
[picture p10: page 10]

3V3 BI-DIRECTIONAL IO (5V TOLERANT)

Sheet: /DigitalIO/ Devtank Ltd Part No: 304-007 R126

File: DigitalIO.sch
Id: 10/11 Title: Sensi Board

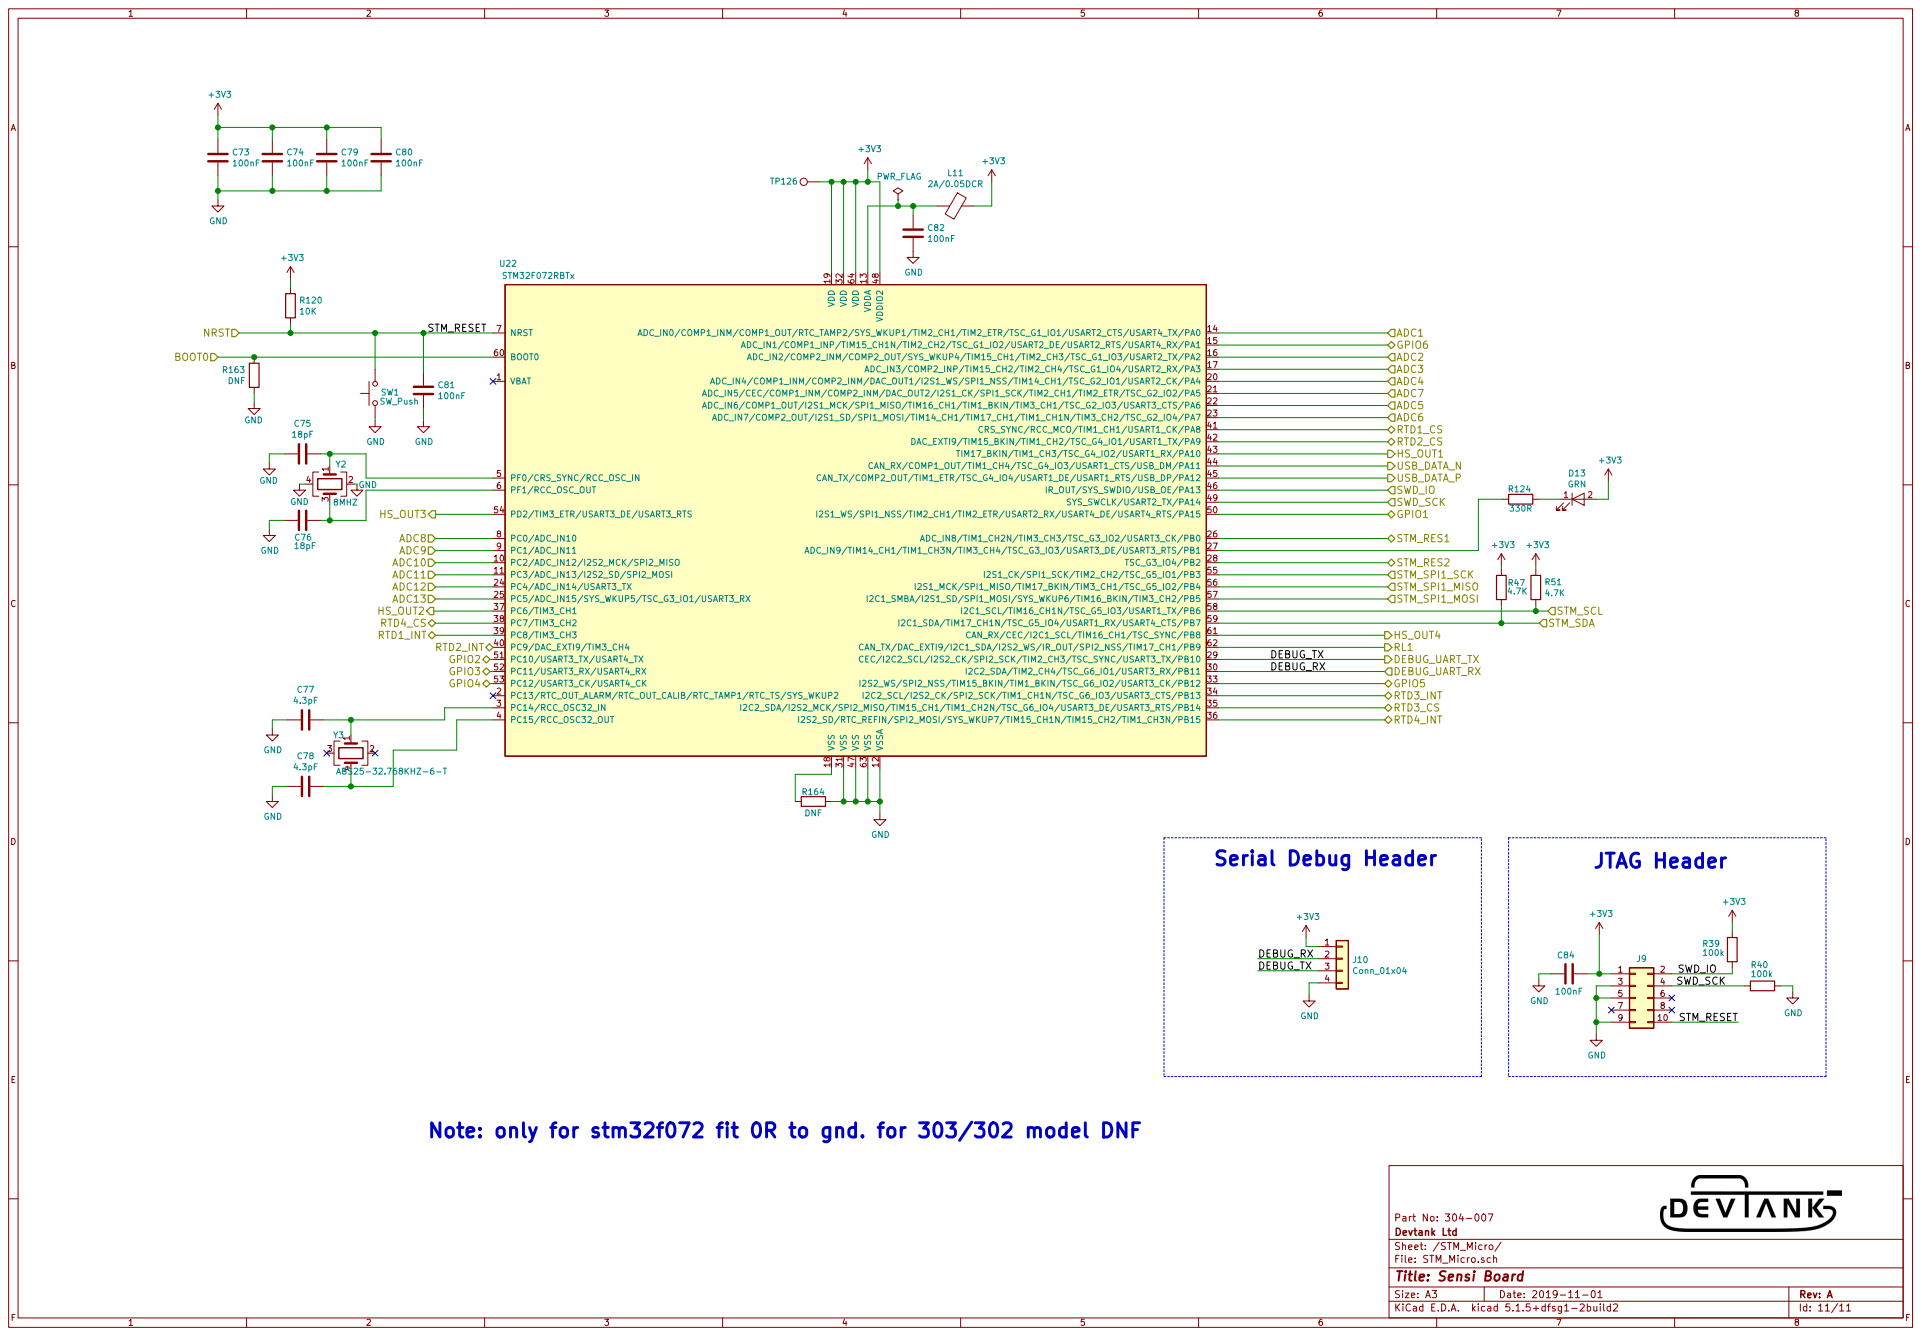
[picture p11: page 11]

Note: only for stm32f072 fit 0R to gnd. for 303/302 model DNF

Sheet: /STM_Micro/ Devtank Ltd Part No: 304-007

File: STM_Micro.sch
Id: 11/11 Title: Sensi Board
