devtank-ltd/kicad_hiltop_seni_board/kicad_hiltop_sensi_board/Sensi_Board.kicad_pcb

## KiCad design kicad_hiltop_sensi_board/Sensi_Board.kicad_pcb (2022-10-13)

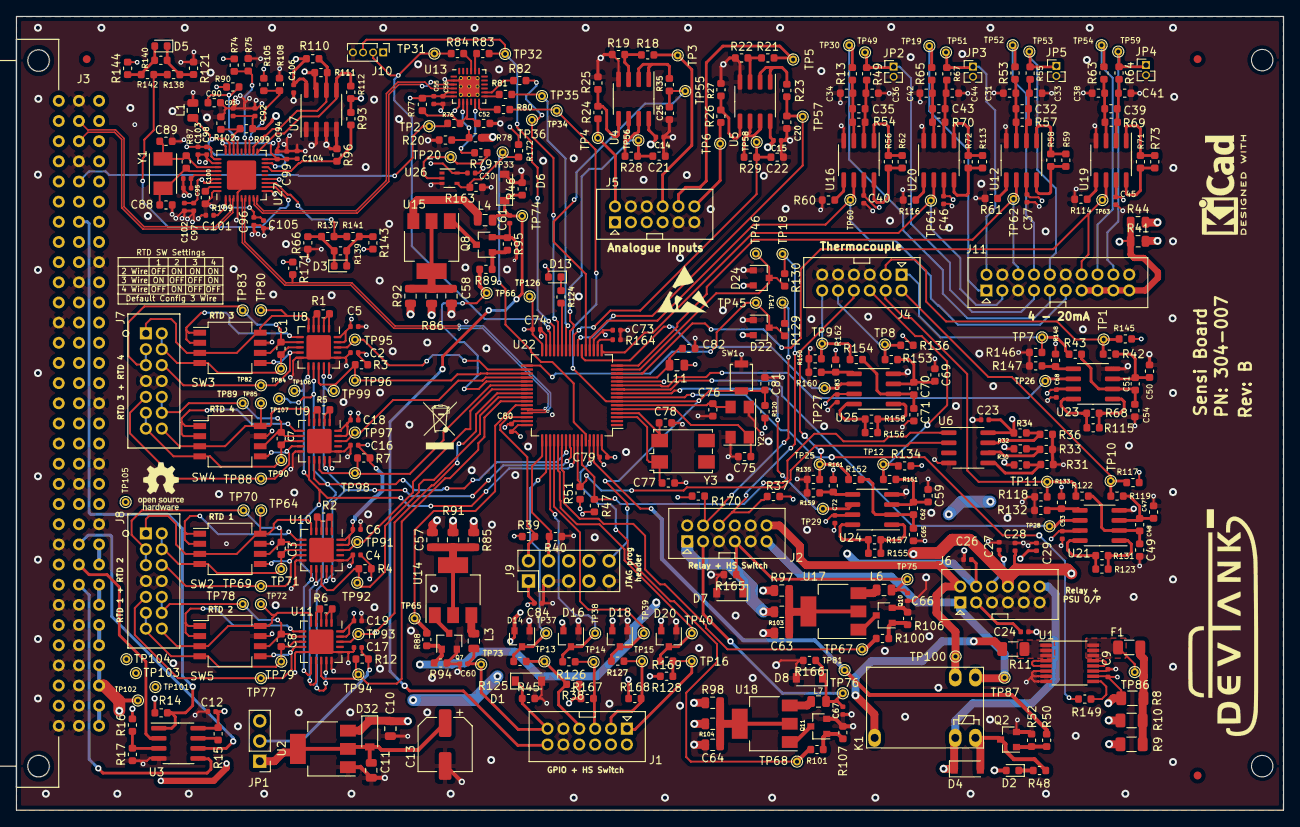
[picture p12: board Sensi_Board.kicad_pcb from above]

Board: 4 copper layers, 159.6 x 100.0 mm, 451 parts (0 on the bottom side), 240 nets.

Parts:
C1, C3, C7, C8, C20, C21, C22, C25, C32, C35, C39, C43, C48, C51, C52, C62, C70, C81, C82, C90: 100nF; C_0603_1608Metric
C2, C4, C5, C6, C9, C12, C14, C15, C16, C17, C18, C19, C23, C24, C26, C27, C28, C29, C30, C37, C40, C45, C46, C53, C56, C60, C61, C66, C67, C68, C72, C73, C74, C79, C80, C83, C84, C92, C94, C95, C96, C97, C98, C99, C101: 100nF; C_0402_1005Metric
C10, C11: 10uF; C_0805_2012Metric
C13: 100uF; CP_Elec_6.3x7.7
C31, C33, C34, C36, C38, C41, C42, C44: 1uF; C_0603_1608Metric
C47, C49, C50, C54, C59, C65, C69, C71: 1nF; C_0603_1608Metric
C55, C100, C102, C103, C104, C105: 4.7uF; C_0402_1005Metric
C57, C58, C63, C64: DNF; C_0805_2012Metric
C75, C76: 18pF; C_0603_1608Metric
C77, C78: 4.3pF; C_0603_1608Metric
C88, C89: 33pF; C_0603_1608Metric
C91: 1uF; C_0402_1005Metric
C106: DNF; C_0402_1005Metric
D1, D6, D7, D8: D_Schottky; D_SOD-123
D2, D3, D5, D13: GRN; LED_0603_1608Metric
D4: BAT54T1G; D_SOD-123
D14, D16, D18, D20, D22, D24: BAV99; SOT-23
D32: MBR230LSFT1G; D_SOD-123
F1: Polyfuse; R_1206_3216Metric
J1, J2, J4, J5, J6: Conn_02x06_Top_Bottom; Molex2x06
J3: Conn_03x32_DIN41612; Socket_DIN41612-CaseC1-full-Male-96Pin-3rows_correct
J7, J8: Conn_02x07_Top_Bottom; 87831-1420_Molex_Milligrid
J9: Conn_02x05_Odd_Even; PinHeader_2x05_P2.54mm_Vertical
J10: Conn_01x04; PinHeader_1x04_P1.27mm_Vertical
J11: Conn_02x10_Counter_Clockwise; Molex_Milligrid_2x10
JP1: Jumper_NC_Dual; PinHeader_1x03_P2.54mm_Vertical
JP2, JP3, JP4, JP5: Jumper_NC_Small; PinHeader_1x02_P1.27mm_Vertical
K1: HRS1KH-S; Relay_SPDT_HRS1KH-S
L1: 500mA/0.10DCR; L_0805_2012Metric
L3, L4, L6, L7, L11: 2A/0.05DCR; L_0805_2012Metric
Q2, Q7, Q8, Q10, Q11: ZXMN6A07F; SOT-23
R1, R2, R5, R6, R50: 470R; R_0603_1608Metric
R3, R4, R7, R12, R14, R18, R21, R24, R26, R37, R52, R75, R77, R99, R105, R111, R120, R132, R133, R147, R148, R159, R160, R161, R162, R170: 10K; R_0603_1608Metric
R8, R9: DNF; R_1206_3216Metric
R10, R11: 0R; R_1206_3216Metric
R13, R49, R53, R55, R63, R64, R65, R67: 68R; R_0603_1608Metric
R15, R16, R47, R51: 4K7; R_0603_1608Metric
R17, R31, R33, R36, R38, R59, R62, R73, R74, R96, R108, R110, R112, R113, R115, R123, R137, R138, R143, R144, R155, R156, R163, R167, R168, R169, R172: DNF; R_0603_1608Metric
R19, R22, R25, R27: 16K; R_0603_1608Metric
R20: 47K; R_0603_1608Metric
R23, R28, R29, R35: 100R; R_0603_1608Metric
R30, R32, R34, R60, R61, R66, R76, R79, R80, R83, R84, R114, R116, R121, R149: 0R; R_0603_1608Metric
R39, R40, R45, R46, R90, R93, R94, R95, R106, R107, R139, R140, R165, R166: 100K; R_0603_1608Metric
R41, R85, R86, R97, R98: DNF; R_0805_2012Metric
R42, R43, R88, R89, R100, R101, R119, R122, R125, R126, R127, R128, R129, R130, R151, R152, R153, R154: 1K; R_0603_1608Metric
R44, R91, R92, R103, R104: 0R; R_0805_2012Metric
R48: 2K2; R_0603_1608Metric
R54, R57, R69, R70: 30R; R_0603_1608Metric
R56, R58, R71, R72: 12.4K; R_0603_1608Metric
R68, R131, R157, R158: 1.58K; R_0603_1608Metric
R78: 24K; R_0603_1608Metric
R81, R82, R124, R141, R142: 330R; R_0603_1608Metric
R87: 1M; R_0603_1608Metric
R102: 20K; R_0603_1608Metric
R109: 12.0K; R_0603_1608Metric
R117, R118, R134, R135, R136, R145, R146, R150: 10M; R_0603_1608Metric
R164: DNF; R_0402_1005Metric
R171: 1k5; R_0603_1608Metric
SW1: SW_Push; SW_SPST_B3U-1000P
SW2, SW3, SW4, SW5: SW_DIP_x04; SW_DIP_SPSTx04_Slide_Copal_CHS-04B_W7.62mm_P1.27mm
TP1, TP2, TP3, TP4, TP5, TP6, TP7, TP8, TP9, TP10, TP11, TP12, TP13, TP14, TP15, TP16, TP17, TP18, TP19, TP20, TP25, TP26, TP27, TP28, TP29, TP30, TP31, TP32, TP33, TP34, TP35, TP36, TP37, TP38, TP39, TP40, TP45, TP46, TP49, TP51, TP52, TP53, TP54, TP55, TP56, TP57, TP58, TP59, TP60, TP61, TP62, TP63, TP64, TP65, TP66, TP67, TP68, TP69, TP70, TP71, TP72, TP73, TP74, TP75, TP76, TP77, TP78, TP79, TP80, TP81, TP82, TP83, TP84, TP85, TP86, TP87, TP88, TP89, TP90, TP91, TP92, TP93, TP94, TP95, TP96, TP97, TP98, TP99, TP100, TP101, TP102, TP103, TP104, TP105, TP106, TP107, TP126: Test_Point; TestPoint_THTPad_D1.0mm_Drill0.5mm
U1: INA250A4; TSSOP-16_4.4x5mm_P0.65mm
U2: LD1117S33TR_SOT223; SOT-223-3_TabPin2
U3: AT25DN512CSSHF-B; SOIC-8_3.9x4.9mm_P1.27mm
U4, U5: AD8646; SOIC-8_3.9x4.9mm_P1.27mm
U6: LM75B; SOIC-8_3.9x4.9mm_P1.27mm
U7: DNF; SOIC-8_3.9x4.9mm_P1.27mm
U8, U9, U10, U11: MAX31865; TQFN-20-1EP_5x5mm_P0.65mm_EP3.1x3.1mm
U12, U16, U19, U20, U21, U23, U24, U25: MAX4194; SOIC-8_3.9x4.9mm_P1.27mm
U13: CP2102N-A01-GQFN24; CP2102_QFN-24-1EP_4x4mm_P0.5mm_EP2.6x2.6mm_ThermalVias_0.3m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
U14, U15, U17, U18: BTS4140N; SOT-223
U22: STM32F072RBTx; LQFP-64_10x10mm_P0.5mm
U26: M74VHC1GT14DFT2G; SOT-353_SC-70-5
U27: USB2502; QFN-36-1EP_6x6mm_P0.5mm_EP3.7x3.7mm
Y1: 50ppm 24.000MHZ; Crystal_SMD_TXC_7A-2Pin_5x3.2mm
Y2: 8MHZ; Crystal_SMD_Abracon_ABM3C-4Pin_5.0x3.2mm
Y3: ABS25-32.768KHZ-6-T; Crystal_SMD_7050-4Pin_7.0x5.0mm

Connections:
+3V3: C2.1, C4.1, C5.1, C6.1, C9.1, C12.2, C16.1, C17.1, C18.1, C19.1, C23.1, C27.1, C30.2, C37.2, C40.2, C45.2, C46.2, C53.2, C55.1, C56.1, C68.2, C72.2, C73.1, C74.1, C79.1, C80.1, C83.2, C84.2, C96.1, C97.1, C98.1, C101.1, C102.1, C103.1, C105.1, C106.1, D13.2, D14.2, D16.2, D18.2, D20.2, D22.2, D24.2, J6.9, J9.1, J10.1, JP1.2, L11.1, R3.1, R4.1, R7.1, R8.2, R12.1, R14.2, R15.2, R16.2, R30.1, R32.1, R34.1, R37.1, R38.1, R39.1, R47.1, R51.1, R74.1, R77.2, R90.1, R93.1, R105.2, R110.2, R112.1, R117.1, R120.1, R133.2, R134.1, R136.1, R143.2, R144.2, R145.1, R148.2, R161.2, R162.2, R167.1, R168.1, R169.1, R170.1, R171.1, R172.1, TP126.1, U1.10, U3.8, U6.8, U7.8, U8.19, U8.20, U9.19, U9.20, U10.19, U10.20, U11.19, U11.20, U12.7, U13.5, U13.6, U13.7, U16.7, U19.7, U20.7, U21.7, U22.19, U22.32, U22.48, U22.64, U23.7, U24.7, U25.7, U26.5, U27.1, U27.7, U27.13, U27.28, U27.33, U27.34
+3V3_BP: J3.7c, J3.8c, JP1.3, TP104.1
+3V3_LOC: C11.2, C13.1, D32.2, JP1.1, U2.2
+5V: C10.2, C14.2, C15.2, C29.1, C91.1, C92.1, D2.2, D4.1, D32.1, J3.3c, J3.4c, J5.1, J5.2, J5.3, J5.4, J6.12, K1.5, R78.2, R99.1, TP102.1, U2.3, U4.8, U5.8
+12V: C28.1, J3.1c, J3.2c, J6.10, R10.2, R41.2, R85.1, R86.1, R97.1, R98.1, TP101.1
-5V: C26.1, J3.5c, J3.6c, J6.8, TP103.1
/AIN_BUF_CH1: C25.2, R35.1, TP55.1, U22.21
/AIN_BUF_CH2: C21.2, R28.1, TP56.1, U22.25
/AIN_BUF_CH3: C20.2, R23.1, TP57.1, U22.23
/AIN_BUF_CH4: C22.2, R29.1, TP58.1, U22.24
/AIN_CH1: J5.10, R18.2, TP3.1
/AIN_CH2: J5.7, R24.2, TP4.1
/AIN_CH3: J5.11, R21.2, TP5.1
/AIN_CH4: J5.12, R26.2, TP6.1
/F1+: J11.5, R13.2, TP30.1
/F1-: J11.4, JP2.1, R49.2, TP49.1
/F1_OUT: J11.6, TP60.1, U16.6, U22.20
/F2+: J11.1, R65.2, TP19.1
/F2-: J11.11, JP3.1, R67.2, TP51.1
/F2_OUT: J11.2, TP61.1, U20.6, U22.17
/F3+: J11.14, R53.2, TP52.1
/F3-: J11.15, JP5.1, R55.2, TP53.1
/F3_OUT: J11.13, TP62.1, U12.6, U22.16
/F4+: J11.18, R63.2, TP54.1
/F4-: J11.19, JP4.1, R64.2, TP59.1
/F4_OUT: J11.17, TP63.1, U19.6, U22.14
/F_Vs: J11.7, J11.8, J11.9, J11.10, R41.1, R44.1
/GPIO1: D14.3, R125.1, TP37.1, U22.50
/GPIO1_EXT: J1.4, R38.2, R125.2, TP13.1
/GPIO2: D16.3, R126.1, TP38.1, U22.51
/GPIO2_EXT: J1.3, R126.2, R167.2, TP14.1
/GPIO3: D18.3, R127.1, TP39.1, U22.52
/GPIO3_EXT: J1.2, R127.2, R168.2, TP15.1
/GPIO4: D20.3, R128.1, TP40.1, U22.53
/GPIO4_EXT: J1.1, R128.2, R169.2, TP16.1
/GPIO5: D22.3, R129.1, TP45.1, U22.33
/GPIO5_EXT: J2.8, R129.2, R170.2, TP17.1
/GPIO6: D24.3, R130.1, TP46.1, U22.15
/GPIO6_EXT: J2.9, R37.2, R130.2, TP18.1
/HS_CTRL_SW1: R88.2, TP65.1, U22.43
/HS_CTRL_SW2: R89.2, TP66.1, U22.37
/HS_CTRL_SW3: R100.2, TP67.1, U22.54
/HS_CTRL_SW4: R101.2, TP68.1, U22.61
/HS_OUT1: C60.1, D1.1, J1.6, L3.1, R45.1, TP73.1
/HS_OUT2: C61.1, D6.1, J1.12, L4.1, R46.1, TP74.1
/HS_OUT3: C66.1, D7.1, J2.4, L6.1, R165.1, TP75.1
/HS_OUT4: C67.1, D8.1, J2.2, L7.1, R166.1, TP76.1
/I_MON: R149.2, U1.9
/OUT1_COM: K1.2, R11.1
/OUT1_NC: J2.6, J6.1, K1.4, TP87.1
/OUT1_NO: J2.12, J6.7, K1.3, TP100.1
/PORT_SEL: J3.26b, R14.1, U3.1
/RESET: J3.28b, R76.2, TP2.1
/RL1_OUT: R50.2, TP81.1, U22.62
/RTD1_CS: R4.2, TP92.1, U10.13, U22.41
/RTD1_F+: J8.1, SW2.3, SW2.8, TP64.1, U10.5
/RTD1_F-: J8.10, SW2.5, TP69.1, U10.9
/RTD1_INT: TP91.1, U10.18, U22.39
/RTD1_R+: C3.2, J8.2, J8.3, SW2.6, TP70.1, U10.7
/RTD1_R-: C3.1, J8.8, J8.9, SW2.4, TP71.1, U10.8
/RTD2_CS: R12.2, TP94.1, U11.13, U22.42
/RTD2_F+: J8.14, SW5.3, SW5.8, TP72.1, U11.5
/RTD2_F-: J8.5, SW5.5, TP77.1, U11.9
/RTD2_INT: TP93.1, U11.18, U22.40
/RTD2_R+: C8.2, J8.12, J8.13, SW5.6, TP78.1, U11.7
/RTD2_R-: C8.1, J8.6, J8.7, SW5.4, TP79.1, U11.8
/RTD3_CS: R3.2, TP96.1, U8.13, U22.35
/RTD3_F+: J7.1, SW3.3, SW3.8, TP80.1, U8.5
/RTD3_F-: J7.10, SW3.5, TP82.1, U8.9
/RTD3_INT: TP95.1, U8.18, U22.34
/RTD3_R+: C1.2, J7.2, J7.3, SW3.6, TP83.1, U8.7
/RTD3_R-: C1.1, J7.8, J7.9, SW3.4, TP84.1, U8.8
/RTD4_CS: R7.2, TP98.1, U9.13, U22.38
/RTD4_F+: J7.14, SW4.3, SW4.8, TP85.1, U9.5
/RTD4_F-: J7.5, SW4.5, TP88.1, U9.9
/RTD4_INT: TP97.1, U9.18, U22.36
/RTD4_R+: C7.2, J7.12, J7.13, SW4.6, TP89.1, U9.7
/RTD4_R-: C7.1, J7.6, J7.7, SW4.4, TP90.1, U9.8
/SPI0_CLK: J3.10b, U3.6
/SPI0_MISO: J3.9b, U3.2
/SPI0_MOSI: J3.8b, U3.5
/STM_BOOT0_OUT: R163.1, R172.2, TP33.1, U22.60, U26.4
/STM_DEBUG_RX: J10.2, R84.1, TP31.1, U22.30
/STM_DEBUG_TX: J10.3, R83.1, TP32.1, U22.29
/STM_Micro/ADC8: R149.1, U22.8
/STM_RES1: R81.1, TP35.1, U22.26
/STM_RES2: R82.1, TP36.1, U22.28
/STM_RESET: C81.1, J9.10, R80.1, R120.2, SW1.2, TP34.1, U22.7
/STM_SCL: R51.2, U6.2, U22.58
/STM_SDA: R47.2, U6.1, U22.59
/STM_SPI1_MISO: TP99.1, U8.14, U9.14, U10.14, U11.14, U22.56
/STM_SPI1_MOSI: TP106.1, U8.11, U9.11, U10.11, U11.11, U22.57
/STM_SPI1_SCK: TP107.1, U8.12, U9.12, U10.12, U11.12, U22.55
/STM_USB_DATA_N: U22.44, U27.5
/STM_USB_DATA_P: R171.2, U22.45, U27.6
/SWD_IO: J9.2, R39.2, U22.46
/SWD_SCK: J9.4, R40.2, U22.49
/TH1+: J4.2, R42.2, R145.2, TP1.1
/TH1-: J4.1, R43.2, R146.1, TP7.1
/TH1_OUT: TP26.1, U22.11, U23.6
/TH2+: J4.11, R136.2, R153.2, TP8.1
/TH2-: J4.12, R150.1, R154.2, TP9.1
/TH2_OUT: TP27.1, U22.22, U25.6
/TH3+: J4.7, R117.2, R119.2, TP10.1
/TH3-: J4.8, R118.1, R122.2, TP11.1
/TH3_OUT: TP28.1, U21.6, U22.10
/TH4+: J4.9, R134.2, R151.2, TP12.1
/TH4-: J4.10, R135.1, R152.2, TP25.1
/TH4_OUT: TP29.1, U22.9, U24.6
/USB_DATA_N: J3.30b, U27.3
/USB_DATA_P: J3.31b, U27.2
/USB_DEBUG_N: U13.4, U27.9
/USB_DEBUG_P: U13.3, U27.8
ADJ_DC: C24.1, J2.1, J3.9c, J3.10c, J6.2, R9.2, R44.2, R91.1, R92.1, R103.1, R104.1, TP105.1
GND: C2.2, C4.2, C5.2, C6.2, C9.2, C10.1, C11.1, C12.1, C13.2, C14.1, C15.1, C16.2, C17.2, C18.2, C19.2, C20.1, C21.1, C22.1, C23.2, C24.2, C25.1, C26.2, C27.2, C28.2, C29.2, C30.1, C31.1, C33.2, C34.1, C36.2, C37.1, C38.1, C40.1, C41.2, C42.1, C44.2, C45.1, C46.1, C47.1, C49.2, C50.1, C52.2, C53.1, C54.2, C55.2, C56.2, C57.2, C58.2, C59.1, C60.2, C61.2, C63.2, C64.2, C65.2, C66.2, C67.2, C68.1, C69.1, C71.2, C72.1, C73.2, C74.2, C75.2, C76.2, C77.2, C78.2, C79.2, C80.2, C81.2, C82.2, C83.1, C84.1, C88.2, C89.1, C90.2, C91.2, C92.2, C94.2, C95.2, C96.2, C97.2, C98.2, C99.2, C100.2, C101.2, C102.2, C103.2, C104.2, C105.2, C106.2, D1.2, D6.2, D7.2, D8.2, D14.1, D16.1, D18.1, D20.1, D22.1, D24.1, J1.5, J1.11, J2.3, J2.5, J2.7, J2.10, J2.11, J3.1a, J3.1b, J3.2b, J3.3b, J3.4a, J3.4b, J3.5b, J3.6b, J3.7a, J3.7b, J3.10a, J3.11c, J3.13b, J3.14c, J3.17c, J3.21a, J3.23b, J3.24c, J3.29b, J3.32b, J4.3, J4.4, J4.5, J4.6, J5.5, J5.6, J5.8, J5.9, J6.3, J6.4, J6.5, J6.6, J6.11, J7.4, J7.11, J8.4, J8.11, J9.3, J9.5, J9.9, J10.4, J11.3, J11.12, J11.16, J11.20, JP2.2, JP3.2, JP4.2, JP5.2, L1.1, Q2.2, Q7.2, Q8.2, Q10.2, Q11.2, R17.1, R19.1, R20.1, R22.1, R25.1, R27.1, R31.2, R33.2, R36.2, R40.1, R45.2, R46.2, R52.1, R60.2, R61.2, R66.1, R75.1, R94.1, R95.1, R96.1, R102.2, R106.1, R107.1, R108.2, R109.2, R111.2, R114.2, R116.2, R118.2, R121.1, R132.2, R135.2, R146.2, R147.2, R150.2, R159.2, R160.2, R163.2, R164.2, R165.2, R166.2, SW1.1, SW2.7, SW3.7, SW4.7, SW5.7, U1.6, U1.7, U1.8, U1.11, U2.1, U3.4, U4.4, U5.4, U6.4, U7.1, U7.2, U7.3, U7.4, U7.7, U8.10, U8.15, U8.16, U8.21, U9.10, U9.15, U9.16, U9.21, U10.10, U10.15, U10.16, U10.21, U11.10, U11.15, U11.16, U11.21, U12.4, U13.2, U13.25, U16.4, U19.4, U20.4, U21.4, U22.12, U22.31, U22.47, U22.63, U23.4, U24.4, U25.4, U26.3, U27.4, U27.10, U27.29, U27.36, U27.37, Y2.2, Y2.4
unnamed: C31.2, C32.1, R53.1, R57.1, U12.3
unnamed: C32.2, C33.1, R55.1, R57.2, U12.2
unnamed: C34.2, C35.1, R13.1, R54.1, U16.3
unnamed: C35.2, C36.1, R49.1, R54.2, U16.2
unnamed: C38.2, C39.1, R63.1, R69.1, U19.3
unnamed: C39.2, C41.1, R64.1, R69.2, U19.2
unnamed: C42.2, C43.1, R65.1, R70.1, U20.3
unnamed: C43.2, C44.1, R67.1, R70.2, U20.2
unnamed: C47.2, C48.1, R119.1, U21.3
unnamed: C48.2, C49.1, R122.1, U21.2
unnamed: C50.2, C51.1, R42.1, U23.3
unnamed: C51.2, C54.1, R43.1, U23.2
unnamed: C52.1, R76.1, R77.1, U13.9
unnamed: C57.1, R85.2, R91.2, U14.2, U14.4
unnamed: C58.1, R86.2, R92.2, U15.2, U15.4
unnamed: C59.2, C62.1, R151.1, U24.3
unnamed: C62.2, C65.1, R152.1, U24.2
unnamed: C63.1, R97.2, R103.2, U17.2, U17.4
unnamed: C64.1, R98.2, R104.2, U18.2, U18.4
unnamed: C69.2, C70.1, R153.1, U25.3
unnamed: C70.2, C71.1, R154.1, U25.2
unnamed: C75.1, U22.5, Y2.1
unnamed: C76.1, U22.6, Y2.3
unnamed: C77.1, U22.3, Y3.1
unnamed: C78.1, U22.4, Y3.4
unnamed: C82.1, L11.2, U22.13
unnamed: C88.1, R87.1, U27.31, Y1.2
unnamed: C89.2, R87.2, U27.30, Y1.1
unnamed: C90.1, R90.2, U27.24
unnamed: C95.1, C100.1, U27.32
unnamed: C94.1, C99.1, C104.1, U27.18, U27.27
unnamed: D2.1, R48.2
unnamed: D3.1, R66.2, R137.1, R139.1
unnamed: D3.2, R139.2, R141.2, R143.1
unnamed: D4.2, K1.1, Q2.3, R48.1
unnamed: D5.1, R121.2, R138.1, R140.1
unnamed: D5.2, R140.2, R142.2, R144.1
unnamed: D13.1, R124.1
unnamed: F1.1, TP86.1, U1.14, U1.15, U1.16
unnamed: F1.2, R8.1, R9.1, R10.1
unnamed: L1.2, U27.17, U27.26
unnamed: L3.2, U14.3
unnamed: L4.2, U15.3
unnamed: L6.2, U17.3
unnamed: L7.2, U18.3
unnamed: Q2.1, R50.1, R52.2
unnamed: Q7.1, R88.1, R94.2
unnamed: Q7.3, U14.1
unnamed: Q8.1, R89.1, R95.2
unnamed: Q8.3, U15.1
unnamed: Q10.1, R100.1, R106.2
unnamed: Q10.3, U17.1
unnamed: Q11.1, R101.1, R107.2
unnamed: Q11.3, U18.1
unnamed: R1.1, U8.1, U8.2
unnamed: R1.2, U8.3, U8.4
unnamed: R2.1, U10.1, U10.2
unnamed: R2.2, U10.3, U10.4
unnamed: R5.1, U9.1, U9.2
unnamed: R5.2, U9.3, U9.4
unnamed: R6.1, U11.1, U11.2
unnamed: R6.2, U11.3, U11.4
unnamed: R11.2, U1.1, U1.2, U1.3
unnamed: R15.1, U3.7
unnamed: R16.1, R17.2, U3.3
unnamed: R18.1, R19.2, U4.3
unnamed: R20.2, R78.1, U13.8
unnamed: R21.1, R22.2, U5.3
unnamed: R23.2, U5.1, U5.2
unnamed: R24.1, R25.2, U4.5
unnamed: R26.1, R27.2, U5.5
unnamed: R28.2, U4.6, U4.7
unnamed: R29.2, U5.6, U5.7
unnamed: R30.2, R31.1, U6.5
unnamed: R32.2, R33.1, U6.6
unnamed: R34.2, R36.1, U6.7
unnamed: R35.2, U4.1, U4.2
unnamed: R56.1, R62.1, U16.1
unnamed: R56.2, R62.2, U16.8
unnamed: R58.1, R59.1, U12.1
unnamed: R58.2, R59.2, U12.8
unnamed: R60.1, U16.5
unnamed: R61.1, U12.5
unnamed: R71.1, R73.1, U19.1
unnamed: R71.2, R73.2, U19.8
unnamed: R74.2, R75.2, U27.22
unnamed: R79.1, TP20.1, U26.2
unnamed: R79.2, U13.11
unnamed: R80.2, U13.12
unnamed: R81.2, U13.13
unnamed: R82.2, U13.14
unnamed: R83.2, U13.20
unnamed: R84.2, U13.21
unnamed: R93.2, R96.2, U27.16
unnamed: R99.2, R102.1, U27.25
unnamed: R105.1, R108.1, U27.21
unnamed: R109.1, U27.35
unnamed: R110.1, R111.1, U7.6, U27.20
unnamed: R112.2, U7.5, U27.19
unnamed: R72.1, R113.1, U20.1
unnamed: R72.2, R113.2, U20.8
unnamed: R114.1, U19.5
unnamed: R68.1, R115.1, U23.1
unnamed: R68.2, R115.2, U23.8
unnamed: R116.1, U20.5
unnamed: R123.1, R131.1, U21.1
unnamed: R123.2, R131.2, U21.8
unnamed: R124.2, U22.27
unnamed: R132.1, R133.1, U21.5
unnamed: R137.2, R141.1, U27.12
unnamed: R138.2, R142.1, U27.11
unnamed: R147.1, R148.1, U23.5
unnamed: R155.1, R157.1, U24.1
unnamed: R155.2, R157.2, U24.8
unnamed: R156.1, R158.1, U25.1
unnamed: R156.2, R158.2, U25.8
unnamed: R159.1, R161.1, U24.5
unnamed: R160.1, R162.1, U25.5
unnamed: R164.1, U22.18
unnamed: SW2.1, SW2.2, U10.6
unnamed: SW3.1, SW3.2, U8.6
unnamed: SW4.1, SW4.2, U9.6
unnamed: SW5.1, SW5.2, U11.6
unnamed: U1.4, U1.5
unnamed: U1.12, U1.13
