devtank-ltd/kicad_hiltop_seni_board/(commit log)

2019-06-06 Setup base project for sensi board
    [DevtankProject.kicad_pcb, DevtankProject.sch]
2019-08-27 added project files
    [DigitalIO.sch, HighSideOutputs.sch, InputConditioning.sch, InputeConditioning.sch, LoTi_Board_BOM.csv, LoTi_Board_BOM.xlsx, LoTi_Board_BOM_draft.csv, RelayOutputs.sch]
2019-08-28 Just about to aad the RTD
    [DigitalIO.sch, HighSideOutputs.sch, InputConditioning.sch, RelayOutputs.sch, STM_Micro.sch, Sensi_Board.sch, Temperature.sch, USB_Debug.sch]
2019-08-28 added RTD sheet
    [RTDinputs.sch]
2019-09-04 updated sensi board for LBBC 04/09/19
    [DigitalIO.sch, HighSideOutputs.sch, InputConditioning.sch, RTDinputs.sch, RelayOutputs.sch, STM_Micro.sch, Sensi_Board.sch, Temperature.sch]
2019-09-04 updated sensi board for LBBC
    [4-20ma inputs.sch, Thermocouple inputs.sch, USB2502 Hub Controller.sch]
2019-09-05 LBBC sensi board upto date schematic and footprints
    [4-20ma inputs.sch, DigitalIO.sch, HighSideOutputs.sch, InputConditioning.sch, RTDinputs.sch, RelayOutputs.sch, STM_Micro.sch, Sensi_Board.sch]
2019-09-11 All sensors connected to STM Microcontroller
    [RTDinputs.sch, STM_Micro.sch, Sensi_Board.sch, USB2502 Hub Controller.sch]
2019-09-11 Change common to be submodule as it should be.
    [DevtankProject.kicad_pcb, DevtankProject.sch]
2019-09-12 LBBC sensi board updated STM ADC pins, connectors added and most errors removed
2019-09-13 Updated LBBC board and Board layout started
    [InputConditioning.sch, RTDinputs.sch, Sensi_Board.sch, USB2502 Hub Controller.sch]
2019-09-17 Started on Sensi Board Layout
    [STM_Micro.sch, Sensi_Board.kicad_pcb, Sensi_Board.sch]
2019-09-19 Updated board layout LBBC sensi board
    [4-20ma inputs.sch, RTDinputs.sch, Sensi_Board.kicad_pcb, Sensi_Board.sch, Thermocouple inputs.sch, USB2502 Hub Controller.sch]
2019-09-20 Updated sensi board layout LBBC
    [RTDinputs.sch, STM_Micro.sch, Sensi_Board.kicad_pcb, Sensi_Board.sch, USB2502 Hub Controller.sch]
2019-09-20 Sensi board updated pin map
    [4-20ma inputs.sch, InputConditioning.sch, RTDinputs.sch, STM_Micro.sch, Sensi_Board.kicad_pcb, Sensi_Board.sch, Thermocouple inputs.sch, USB2502 Hub Controller.sch]
2019-09-25 Updated sensi board pin map and layout before PCB tracking
    [4-20ma inputs.sch, HighSideOutputs.sch, InputConditioning.sch, RTDinputs.sch, STM_Micro.sch, Sensi_Board.kicad_pcb, Sensi_Board.sch, Thermocouple inputs.sch]
2019-09-26 Started PCB routing of Sensi Board LBBC
    [Sensi_Board.kicad_pcb, Sensi_Board.sch, USB2502 Hub Controller.sch]
2019-09-26 Routing complete around the chip of sensi board
    [Sensi_Board.kicad_pcb, Sensi_Board.sch]
2019-09-26 Most of the routing of the sensi board complete
    [Sensi_Board.kicad_pcb, Sensi_Board.sch]
2019-10-01 Most major connections complete and differential tracking done on the Sensi board layout
    [HighSideOutputs.sch, STM_Micro.sch, Sensi_Board.kicad_pcb, Sensi_Board.sch]
2019-10-02 Most routing on Sensi Board complete
    [4-20ma inputs.sch, DigitalIO.sch, HighSideOutputs.sch, InputConditioning.sch, RTDinputs.sch, RelayOutputs.sch, STM_Micro.sch, Sensi_Board.kicad_pcb]
2019-10-02 Take latest common for new Molex connector.
2019-10-02 Pre stitching via for sensi board.
    [STM_Micro.sch, Sensi_Board.kicad_pcb, USB2502 Hub Controller.sch]
2019-10-07 Sensi board with references visible and without stitching vias
    [RTDinputs.sch, STM_Micro.sch, Sensi_Board.csv, Sensi_Board.kicad_pcb, Sensi_Board.sch, USB2502 Hub Controller.sch, USB_Debug.sch]
2019-10-08 Sensi board complete waiting for review
    [Sensi_Board.kicad_pcb]
2019-10-15 Changes to Sensi board after review
    [4-20ma inputs.sch, STM_Micro.sch, Sensi_Board.kicad_pcb, Sensi_Board.sch, Thermocouple inputs.sch, USB2502 Hub Controller.sch]
2019-10-16 Sensi board schematic updated from comments
    [4-20ma inputs.sch, DigitalIO.sch, HighSideOutputs.sch, InputConditioning.sch, RTDinputs.sch, STM_Micro.sch, Sensi_Board.sch, Thermocouple inputs.sch]
2019-10-23 Updated sensi board layout
    [4-20ma inputs.sch, DigitalIO.sch, HighSideOutputs.sch, InputConditioning.sch, RTDinputs.sch, STM_Micro.sch, Sensi_Board.csv, Sensi_Board.kicad_pcb]
2019-10-23 Sensi board layout awaiting review
    [Sensi_Board.kicad_pcb]
2019-10-23 Missing connection added to Sensi Board
    [Sensi_Board.kicad_pcb, Sensi_Board.sch]
2019-10-25 Sensi Board Complete
    [4-20ma inputs.sch, RTDinputs.sch, STM_Micro.sch, Sensi_Board.csv, Sensi_Board.kicad_pcb, Sensi_Board.sch, Thermocouple inputs.sch, USB2502 Hub Controller.sch]
2019-10-25 Sensi Board updated RTD table
    [RTDinputs.sch, Sensi_Board.kicad_pcb]
2019-10-25 Sensi board keeport for u1
    [Sensi_Board.kicad_pcb]
2019-10-25 Sensi board u1 filled in areas added
    [Sensi_Board.kicad_pcb]
2019-10-29 Rev A ordered
    [4-20ma inputs.sch, DigitalIO.sch, HighSideOutputs.sch, InputConditioning.sch, RTDinputs.sch, RelayOutputs.sch, STM_Micro.sch, Sensi_Board.kicad_pcb]
2019-10-29 Take new common with molex and through hole changes.
2019-11-07 Pressure sensor calcs added to 4-20mA circuit
    [4-20ma inputs.sch, DigitalIO.sch, HighSideOutputs.sch, InputConditioning.sch, RTDinputs.sch, RelayOutputs.sch, STM_Micro.sch, Sensi_Board.sch]
2021-02-04 starting revB
    [4-20ma inputs.sch, DigitalIO.sch, HighSideOutputs.sch, InputConditioning.sch, LoTi_Board_BOM.csv, LoTi_Board_BOM.xlsx, LoTi_Board_BOM_draft.csv, RTDinputs.sch]
2021-02-09 revb design updated schematics and layout
    [4-20ma inputs.sch, DigitalIO.sch, HighSideOutputs.sch, InputConditioning.sch, RTDinputs.sch, STM_Micro.sch, Sensi_Board.kicad_pcb, Sensi_Board.sch]
2021-02-09 revB ready for review
    [STM_Micro.sch, Sensi_Board.kicad_pcb, Sensi_Board.sch]
2021-02-10 Sensi Board RevB
    [RelayOutputs.sch, STM_Micro.sch, Sensi_Board.kicad_pcb]
2021-02-10 updated footprints to simplify bom
    [4-20ma inputs.sch, HighSideOutputs.sch, STM_Micro.sch, Sensi_Board.kicad_pcb, Sensi_Board.sch, Thermocouple inputs.sch, USB2502 Hub Controller.sch, USB_Debug.sch]
2021-02-11 fiducials added to pcb
    [Sensi_Board.kicad_pcb]
2021-02-11 cern license added to PCB
    [Sensi_Board.kicad_pcb]
2022-10-13 bom added
    [4-20ma inputs.sch, DigitalIO.sch, HighSideOutputs.sch, InputConditioning.sch, RTDinputs.sch, RelayOutputs.sch, STM_Micro.sch, Sensi_Board.kicad_pcb]
2022-10-13 Update gitignore for new KiCAD's backups.
