devtank-ltd/kicad_hiltop_seni_board/(notices)

Notices in the files:
kicad_hiltop_sensi_board/Sensi_Board.kicad_pcb:
(c) Copyright 2021 Devtank Ltd
Licensed under CERN-OHL-W V2.0
https://cern-ohl.web.cern.ch
parts and their libraries:
Copyright 2016 Accelerated Designs. All rights reserved.
